KCB101/Frankenbook/Pictures/Battery/IMG_3732.jpg

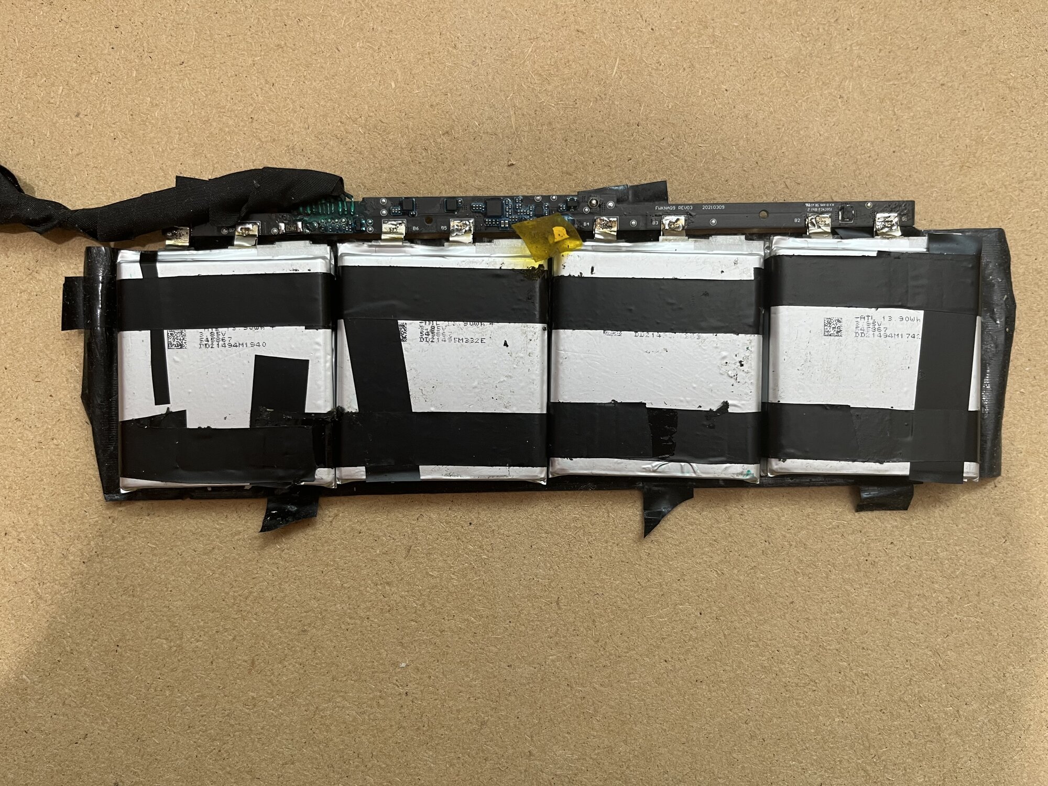
Pictures/Battery/IMG_3732.jpg
