KCB101/Frankenbook/Pictures/Various/IMG_3710.jpg

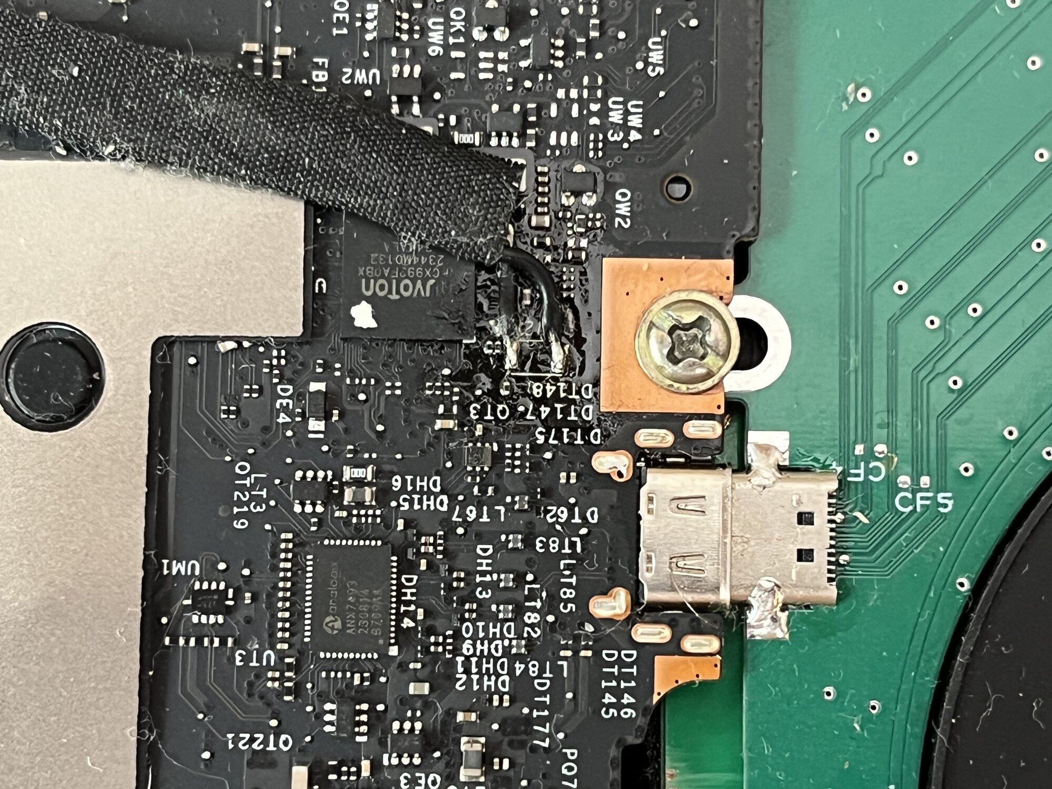
Pictures/Various/IMG_3710.jpg
