KCB101/Frankenbook/ReadMe

This Repo contains the files I used to build my laptop. Also contains some pictures of the parts I build (and modified).
