KCB101/Frankenbook/PCB Design/ReadMe

All PCB Designs were created using Designspark PCB 11.
Some PCB designs had to be modified to work. There is no guarantee that they will work if build exacltly as given. 
The holders and the chargestate PCB is known to need modification as can be seen in the pictures.
