KCB101/Frankenbook/CAD/ReadMe

In this directory all CAD files used for the design are stored. They are all created using Autodesk Inventor 2024.
