KCB101/Frankenbook/Pictures/Full/ReadMe

The green PCBs are the components I build my self. They are build around a framework 13 mainboard.
