KCB101/Frankenbook/Pictures/Speakers/ReadMe

The speakers are force canceling speakers. I first used Frameworks speakers but they rattled
the keyboard and sounded bad. Without EasyEffects they still sound very bad, a dedicated 
DSP would be good but too much work for me.
