KCB101/Frankenbook/CAD/Speaker/ReadMe

The speakers are force canceling speakers using the PUI Audio AS03404MO-SP34 drivers. 
The drivers are two in parallel of two drivers in series for four drivers for each speaker.
The housing for the second side is just mirrored. It is printed using a resin 3d printer.
