KCB101/Frankenbook/Pictures/Battery/IMG_3729.jpg

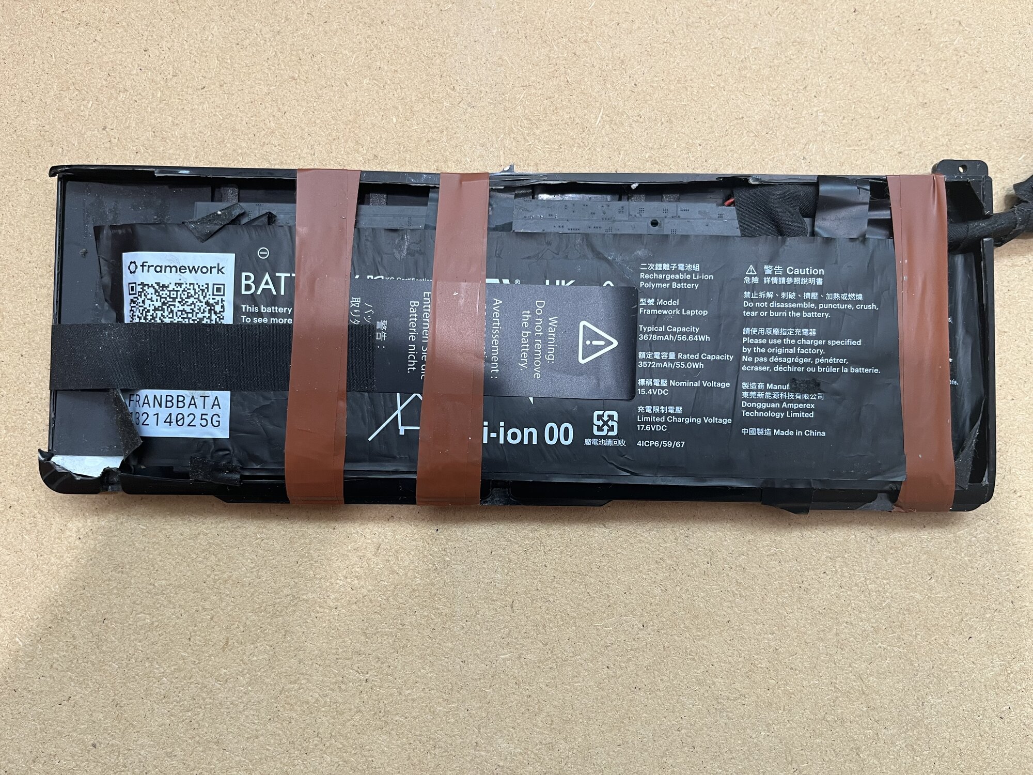
Pictures/Battery/IMG_3729.jpg
