KCB101/Frankenbook/Pictures/Battery/IMG_3730.jpg

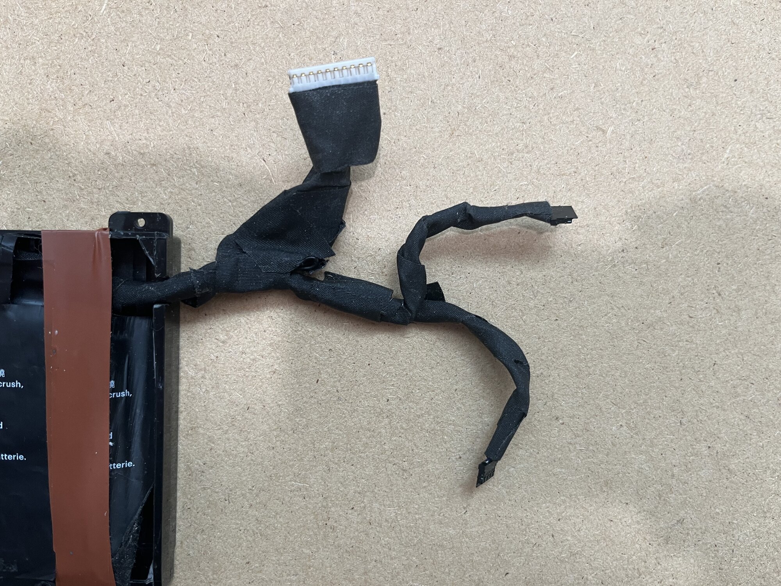
Pictures/Battery/IMG_3730.jpg
