KCB101/Frankenbook/Pictures/Battery/IMG_3733.jpg

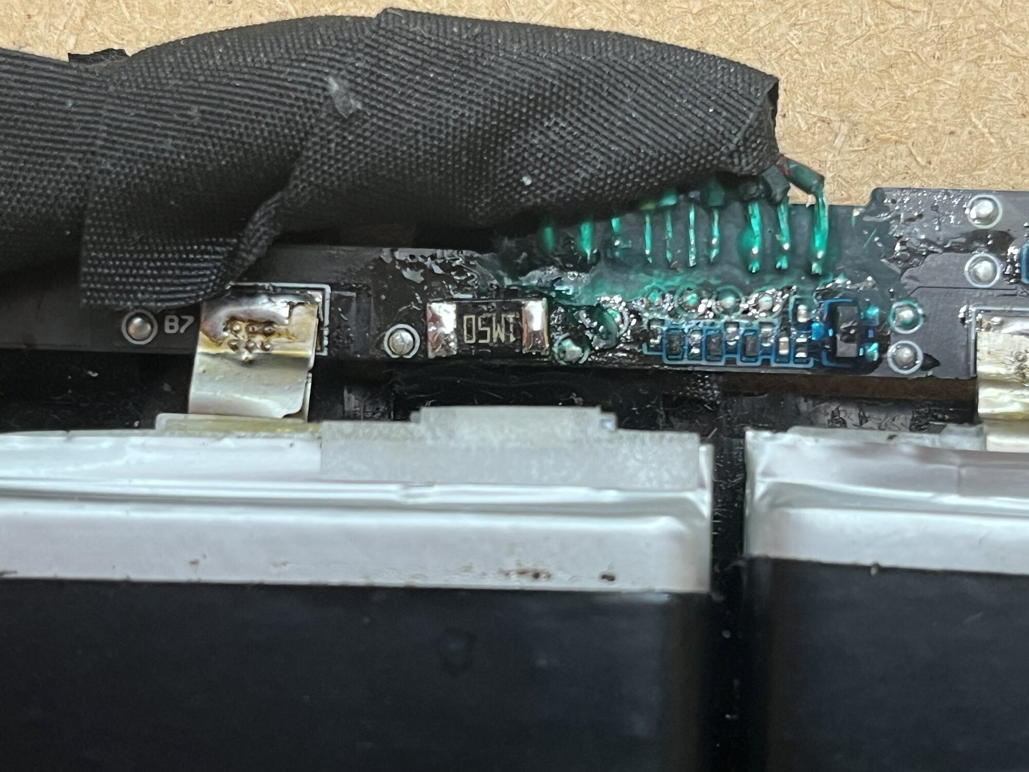
Pictures/Battery/IMG_3733.jpg
