KCB101/Frankenbook/Pictures/Battery/IMG_3735.jpg

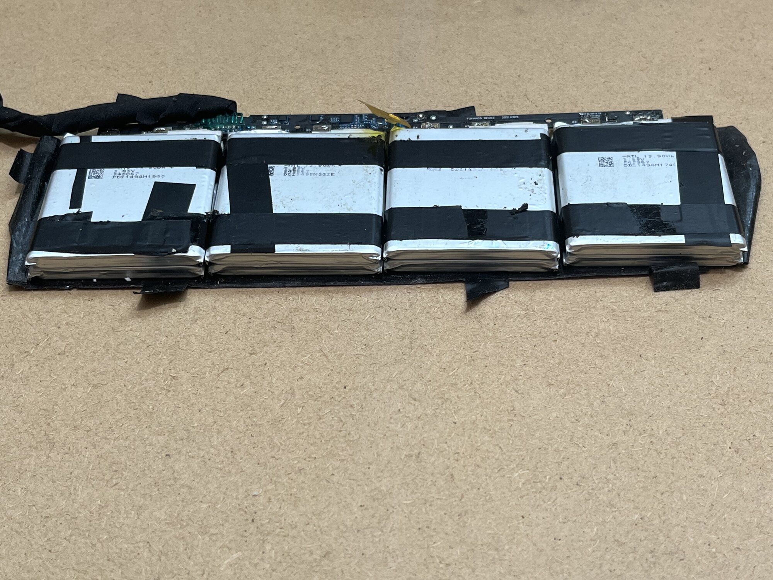
Pictures/Battery/IMG_3735.jpg
