KCB101/Frankenbook/Pictures/Charge State Indicator/IMG_3707.jpg

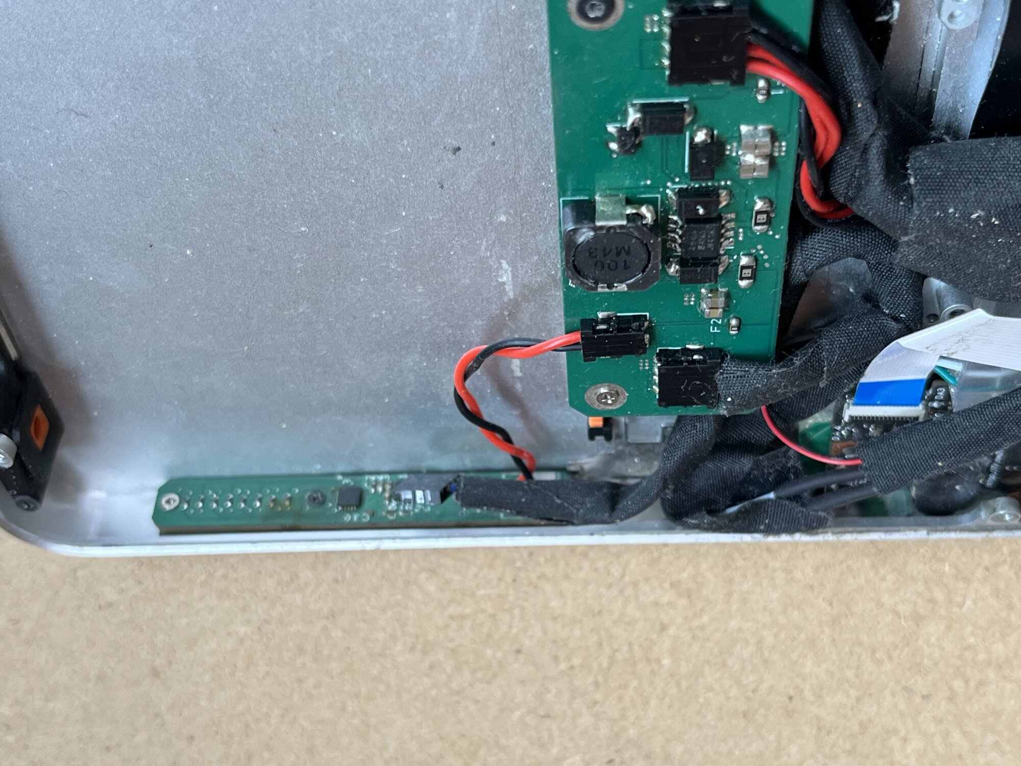
Pictures/Charge State Indicator/IMG_3707.jpg
