KCB101/Frankenbook/Pictures/Charge State Indicator/IMG_3736.jpg

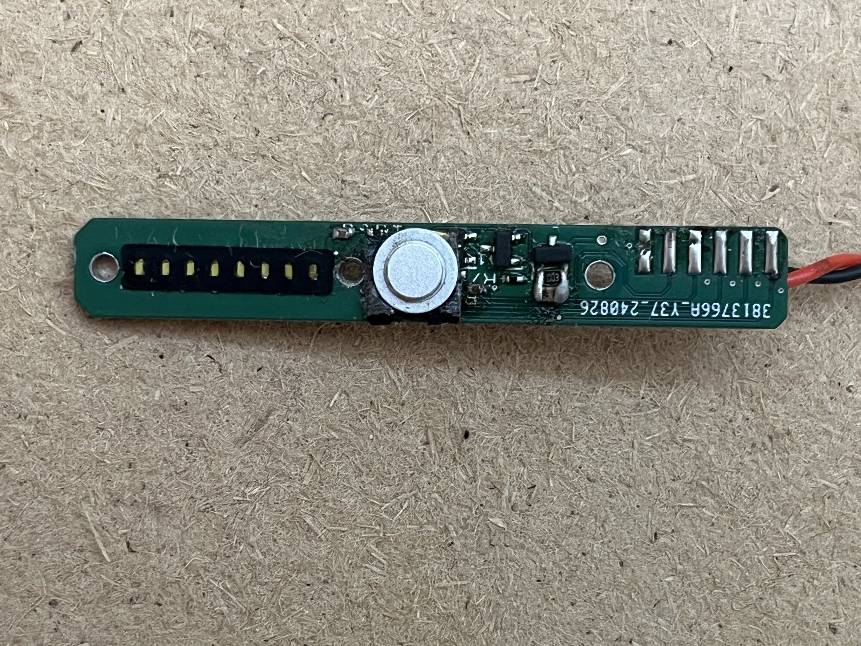
Pictures/Charge State Indicator/IMG_3736.jpg
