KCB101/Frankenbook/Pictures/Charge State Indicator/IMG_3737.jpg

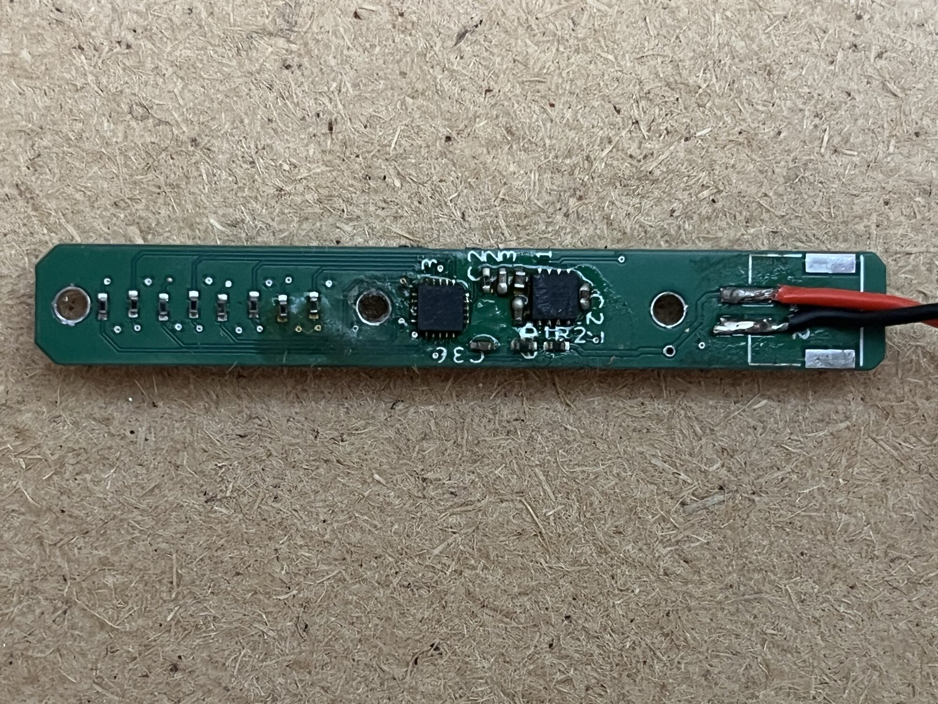
Pictures/Charge State Indicator/IMG_3737.jpg
