KCB101/Frankenbook/Pictures/Charger/IMG_3709.jpg

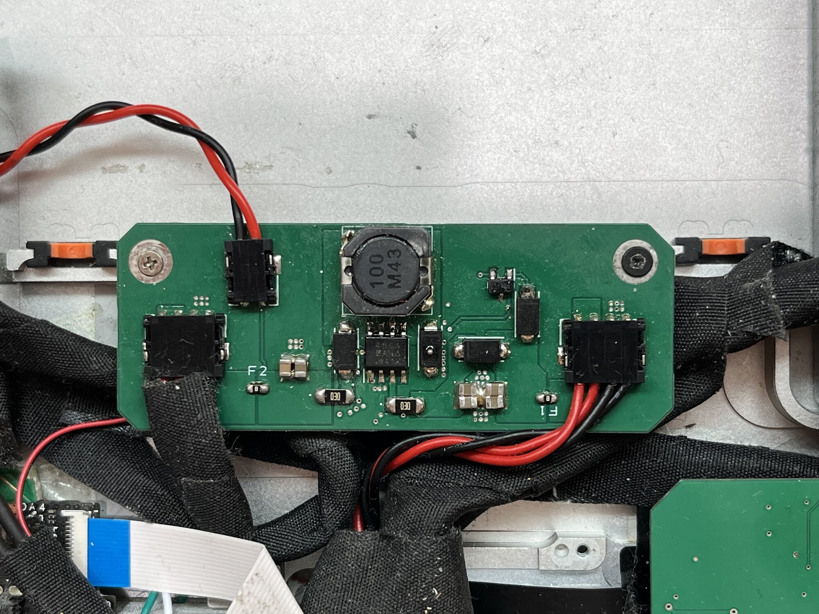
Pictures/Charger/IMG_3709.jpg
