KCB101/Frankenbook/Pictures/Charger/IMG_3727.jpg

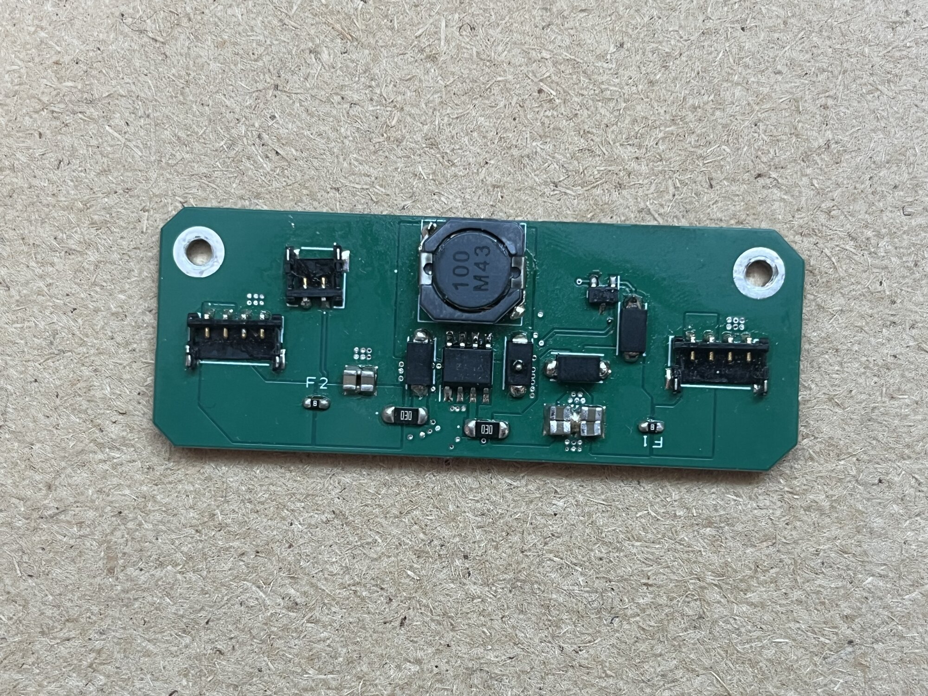
Pictures/Charger/IMG_3727.jpg
