KCB101/Frankenbook/Pictures/Charger/IMG_3728.jpg

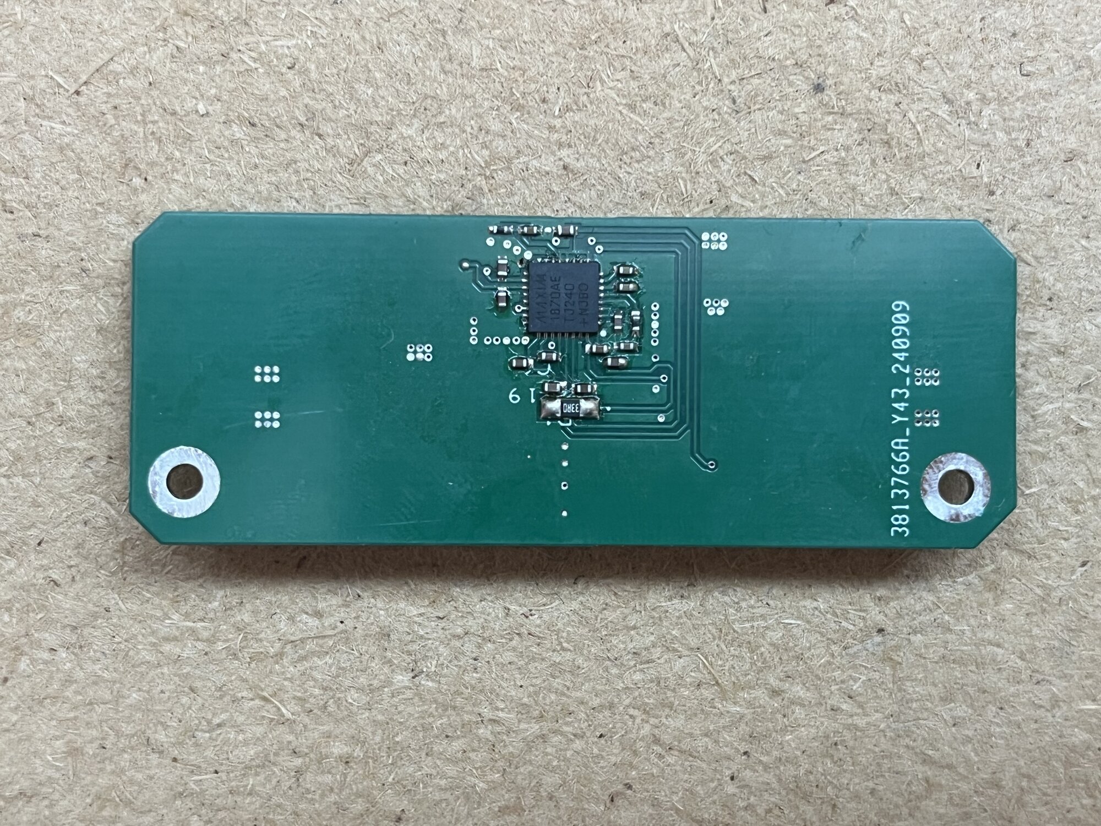
Pictures/Charger/IMG_3728.jpg
