KCB101/Frankenbook/Pictures/External Ports/IMG_3720.jpg

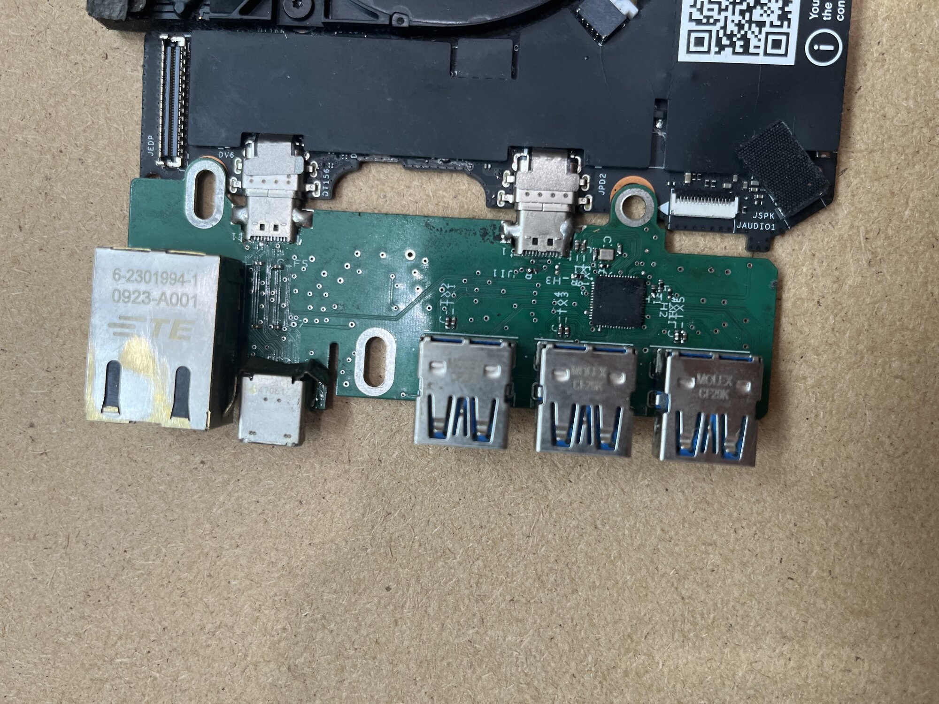
Pictures/External Ports/IMG_3720.jpg
