KCB101/Frankenbook/Pictures/External Ports/IMG_3721.jpg

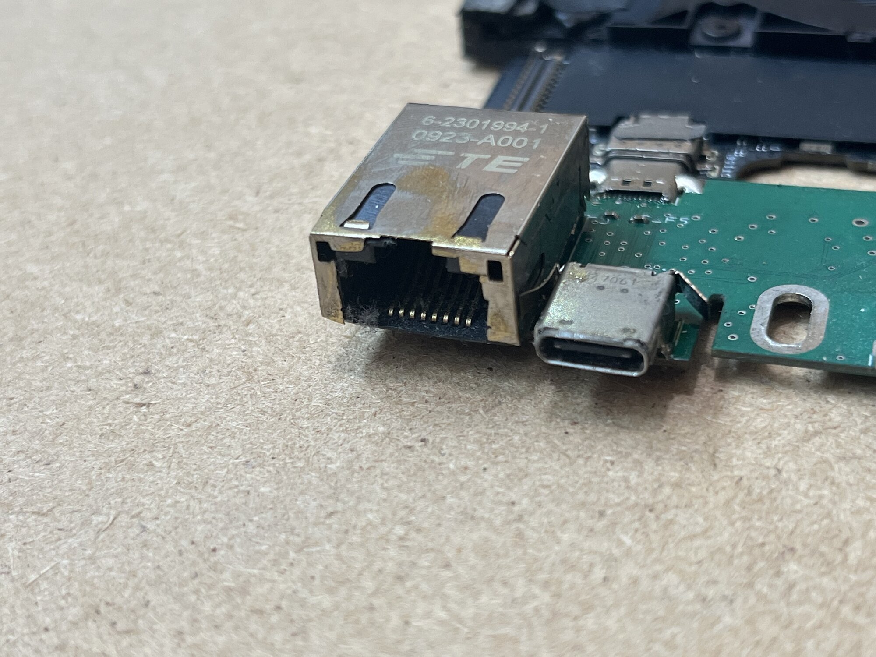
Pictures/External Ports/IMG_3721.jpg
