KCB101/Frankenbook/Pictures/External Ports/IMG_3722.jpg

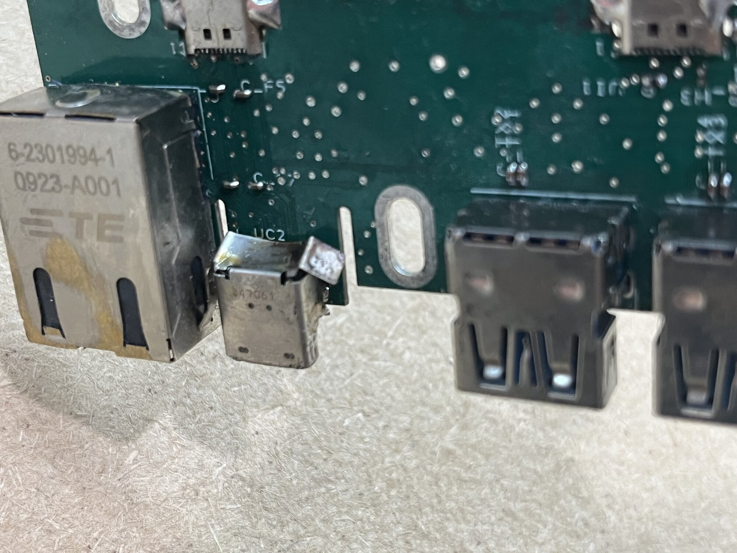
Pictures/External Ports/IMG_3722.jpg
