KCB101/Frankenbook/Pictures/Fans/IMG_3711.jpg

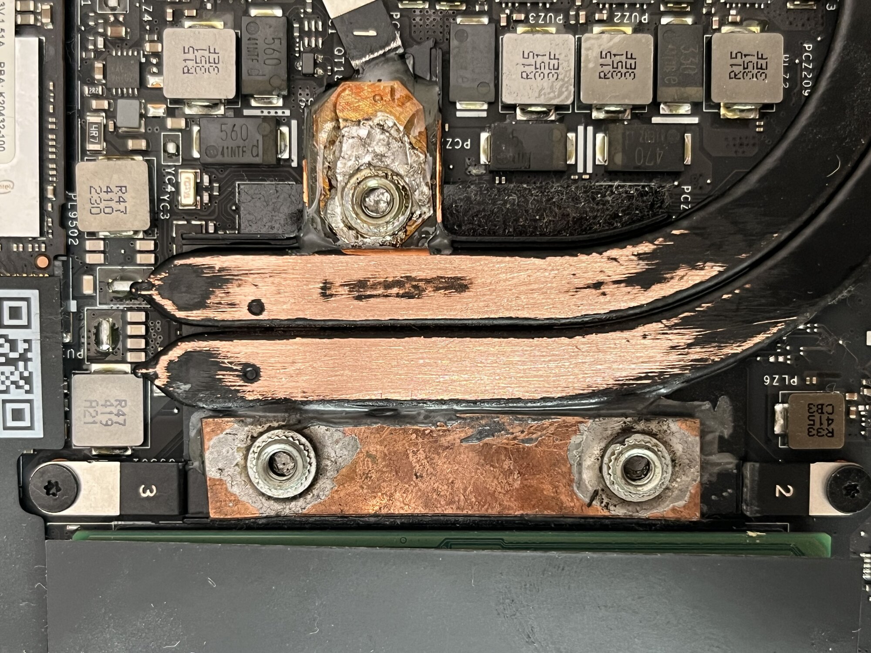
Pictures/Fans/IMG_3711.jpg
