KCB101/Frankenbook/Pictures/Fans/IMG_3714.jpg

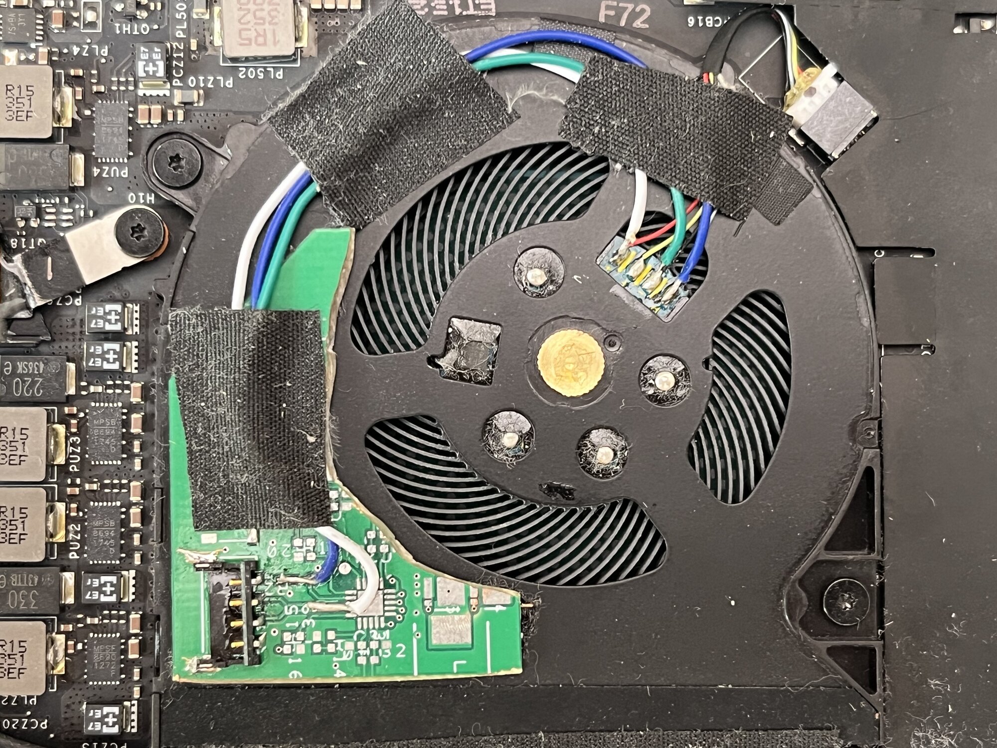
Pictures/Fans/IMG_3714.jpg
