KCB101/Frankenbook/Pictures/Fans/IMG_3715.jpg

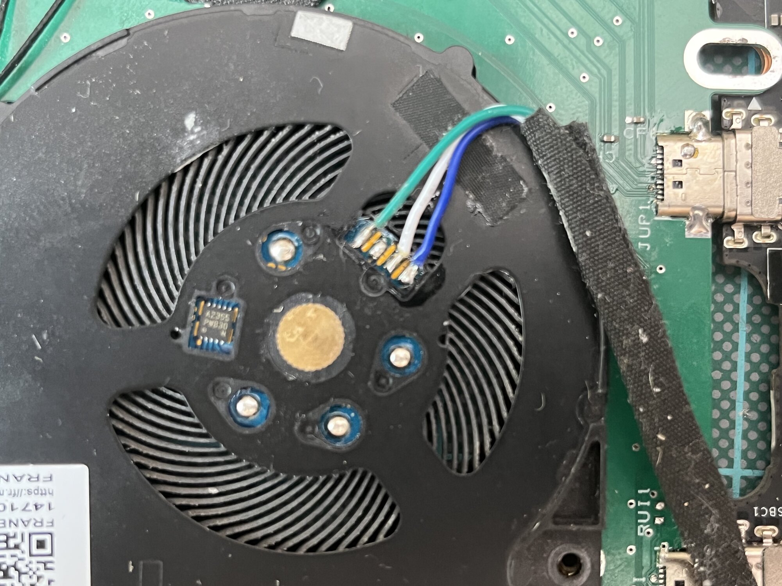
Pictures/Fans/IMG_3715.jpg
