KCB101/Frankenbook/Pictures/Fans/IMG_3719.jpg

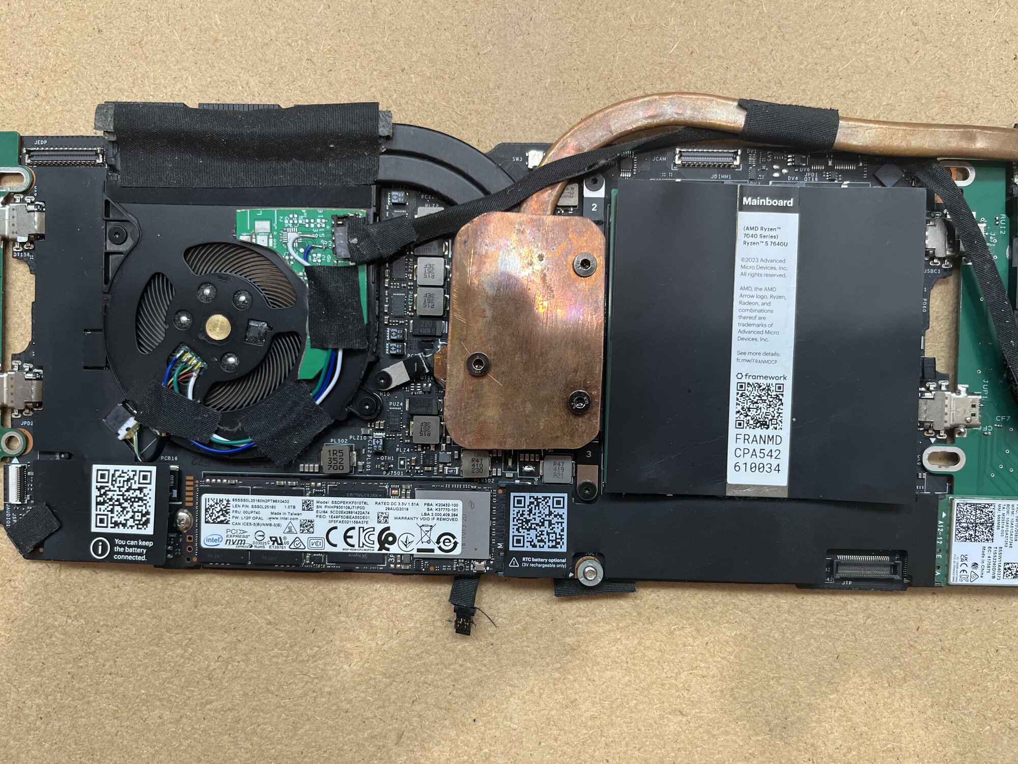
Pictures/Fans/IMG_3719.jpg
