KCB101/Frankenbook/Pictures/Full/IMG_3703.jpg

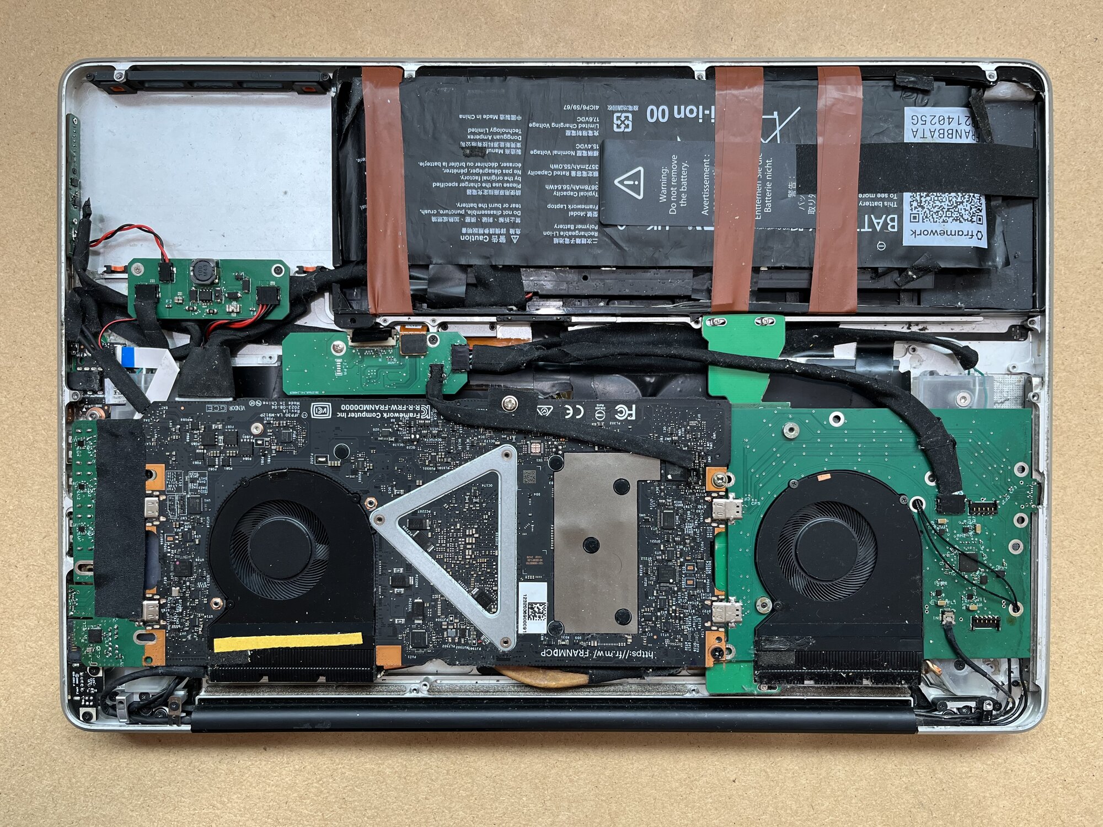
Pictures/Full/IMG_3703.jpg
