KCB101/Frankenbook/Pictures/Full/IMG_3706.jpg

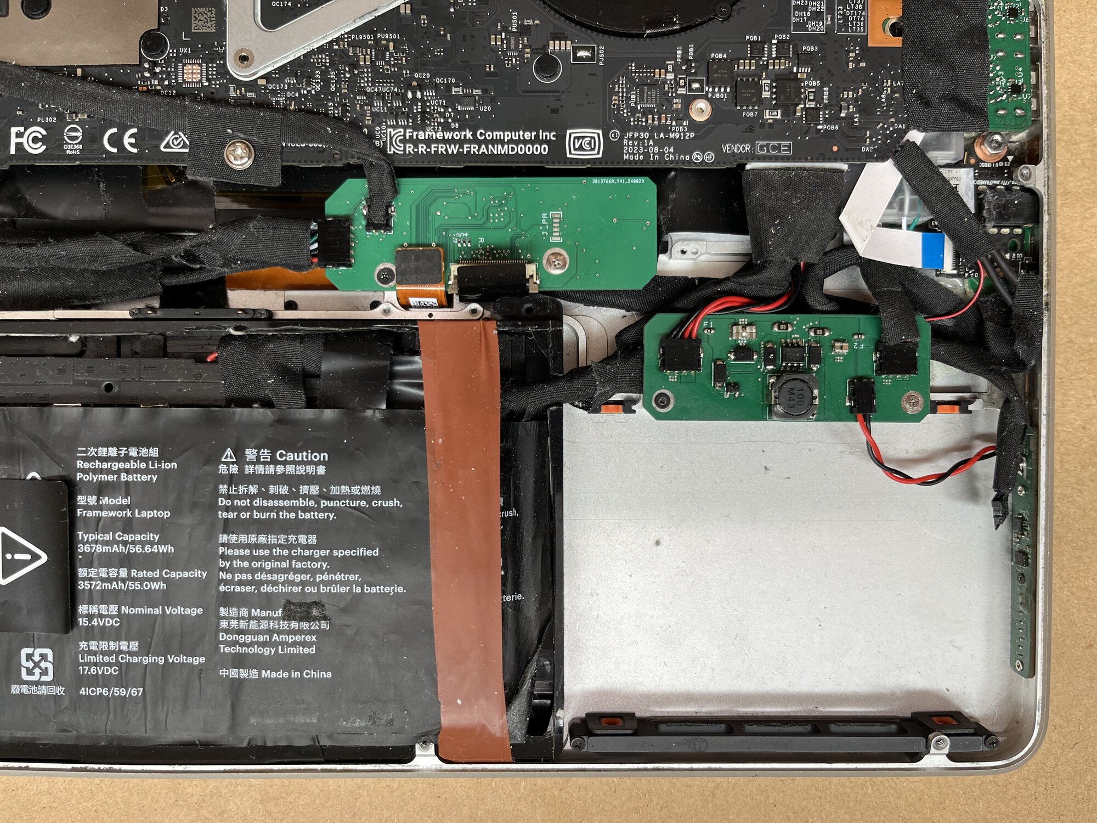
Pictures/Full/IMG_3706.jpg
