KCB101/Frankenbook/Pictures/Full/IMG_3716.jpg

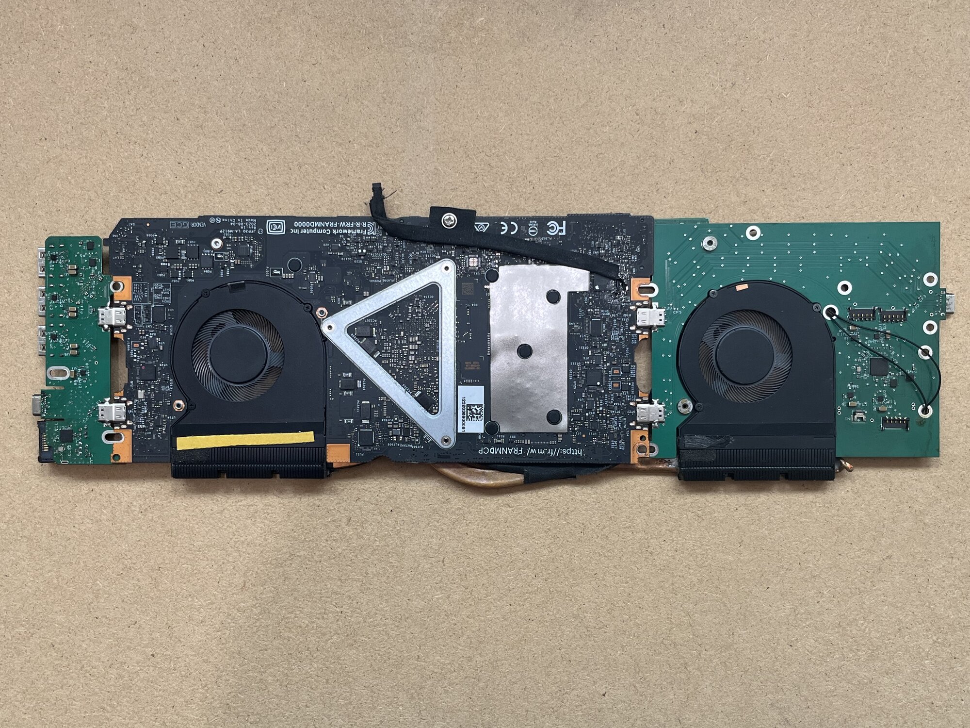
Pictures/Full/IMG_3716.jpg
