KCB101/Frankenbook/Pictures/Full/IMG_3717.jpg

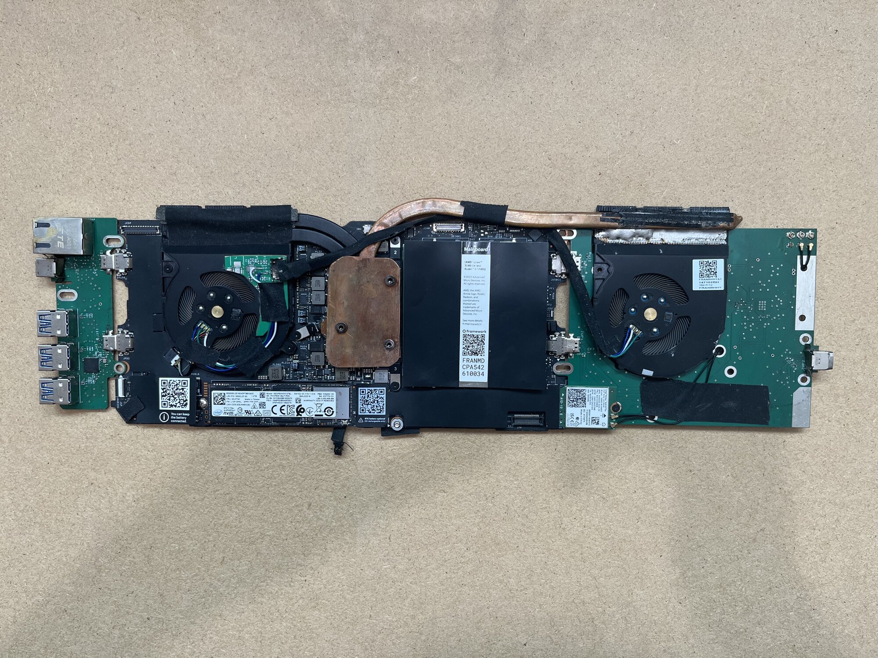
Pictures/Full/IMG_3717.jpg
