KCB101/Frankenbook/Pictures/Full/IMG_3724.jpg

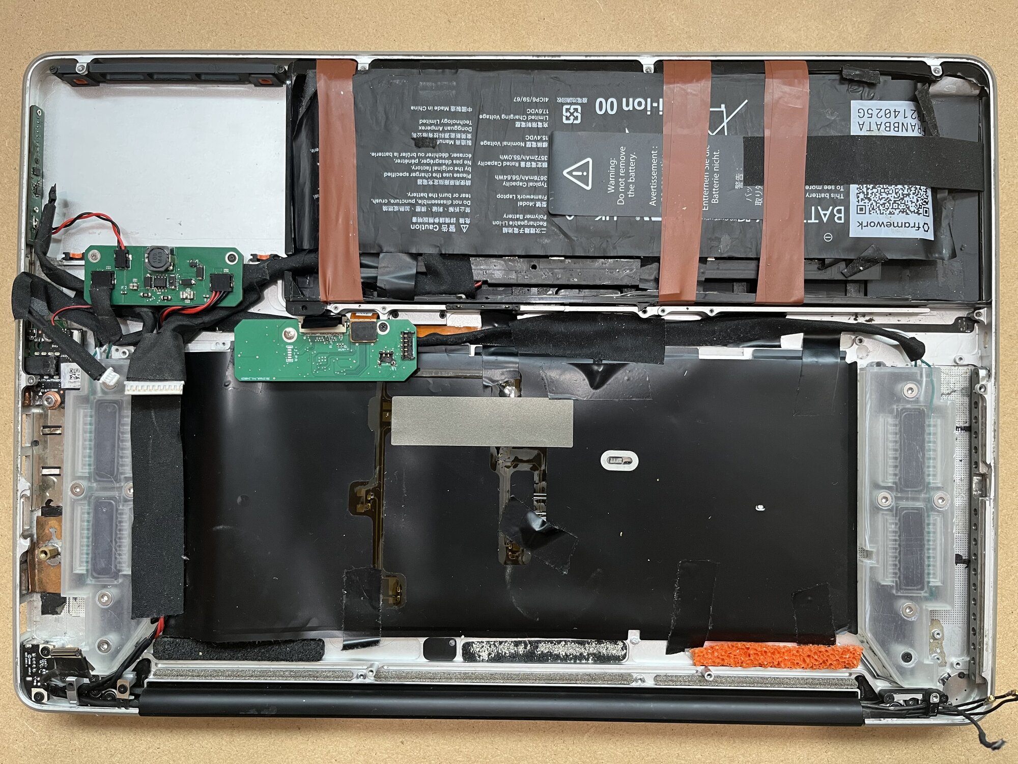
Pictures/Full/IMG_3724.jpg
