KCB101/Frankenbook/Pictures/Keyboard Handler/IMG_3708.jpg

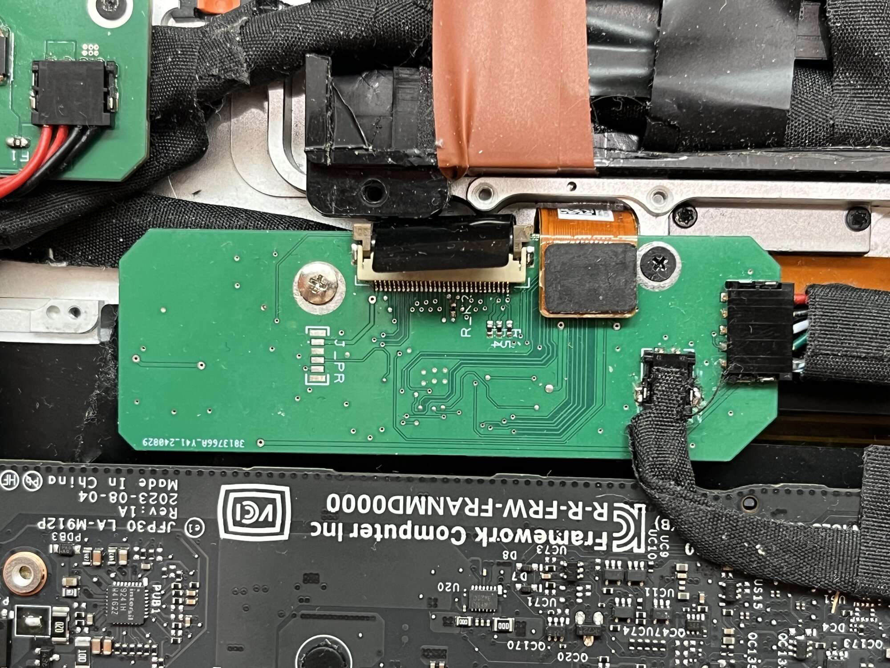
Pictures/Keyboard Handler/IMG_3708.jpg
