KCB101/Frankenbook/Pictures/Keyboard Handler/IMG_3738.jpg

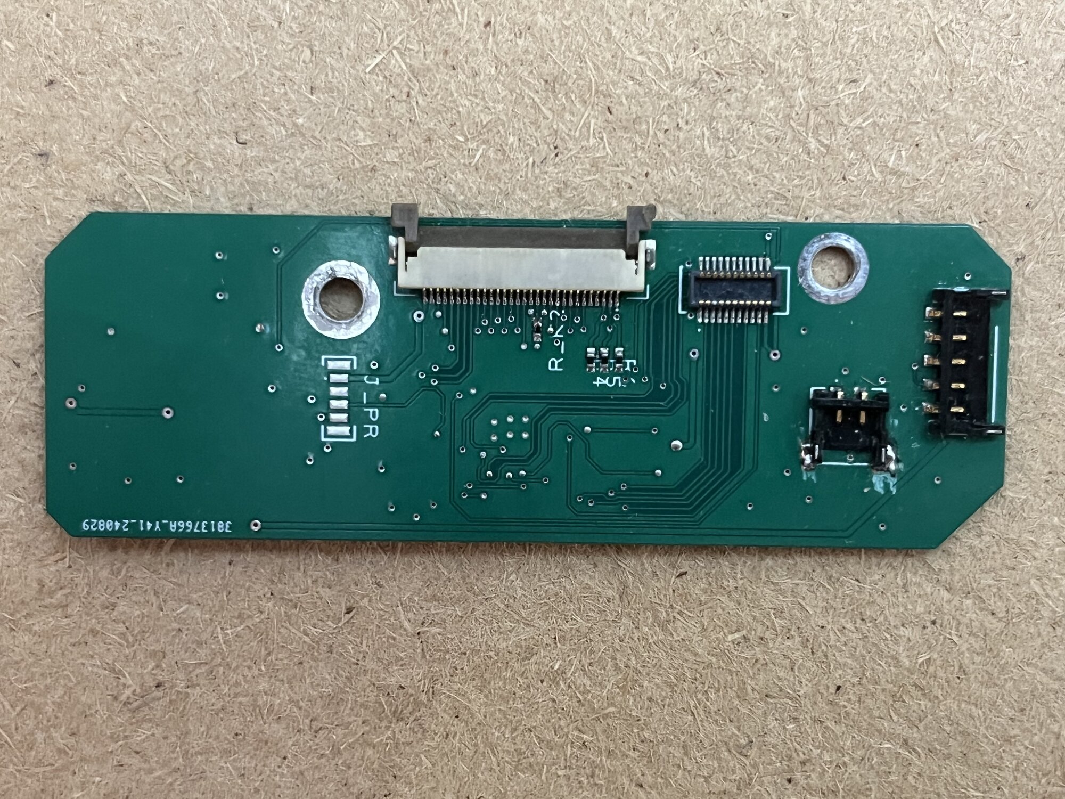
Pictures/Keyboard Handler/IMG_3738.jpg
