KCB101/Frankenbook/Pictures/Keyboard Handler/IMG_3739.jpg

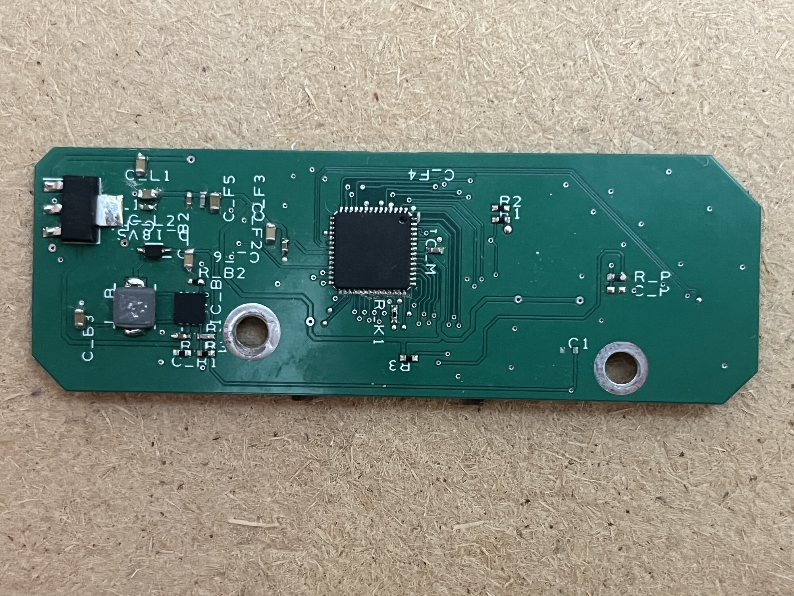
Pictures/Keyboard Handler/IMG_3739.jpg
