KCB101/Frankenbook/Pictures/PCB Internal Ports/IMG_3704.jpg

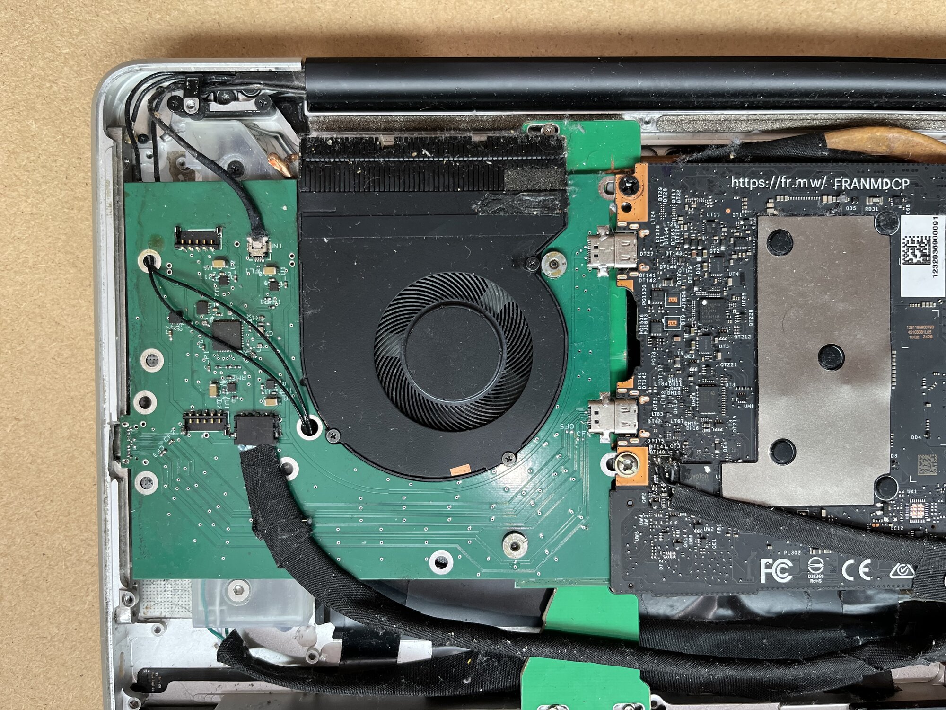
Pictures/PCB Internal Ports/IMG_3704.jpg
