KCB101/Frankenbook/Pictures/PCB Internal Ports/IMG_3712.jpg

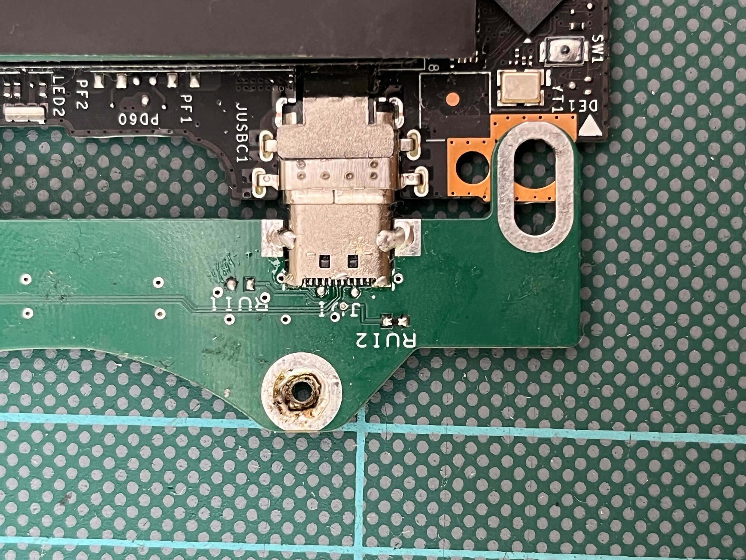
Pictures/PCB Internal Ports/IMG_3712.jpg
