KCB101/Frankenbook/Pictures/PCB Internal Ports/IMG_3718.jpg

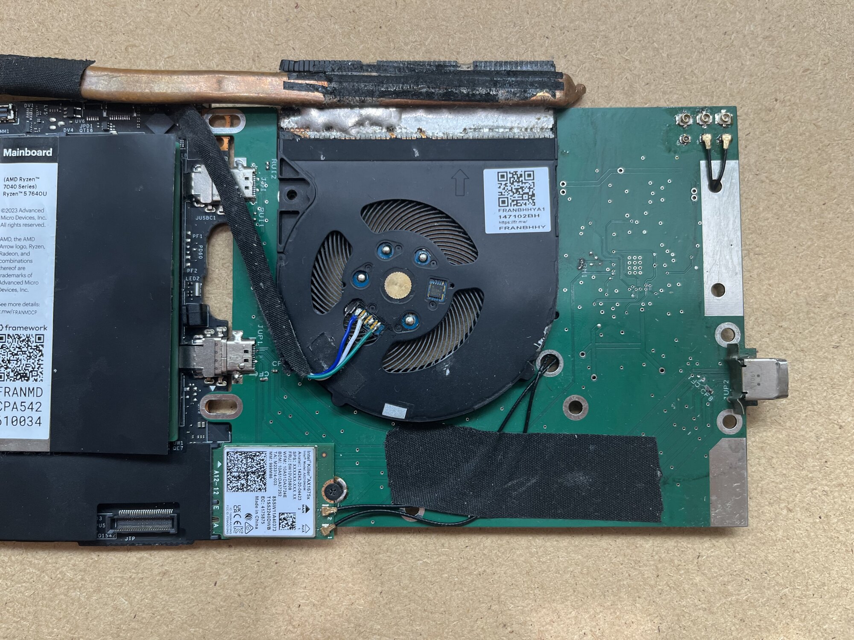
Pictures/PCB Internal Ports/IMG_3718.jpg
