KCB101/Frankenbook/Pictures/PCB Internal Ports/IMG_3723.jpg

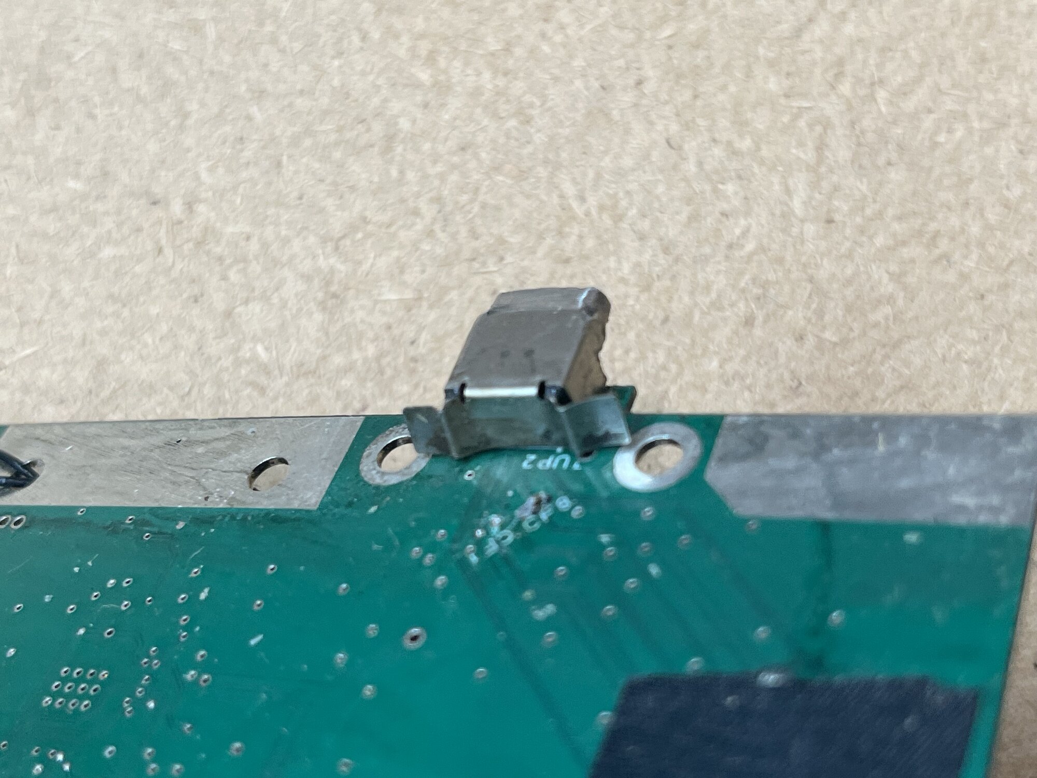
Pictures/PCB Internal Ports/IMG_3723.jpg
