KCB101/Frankenbook/Pictures/Screen/IMG_3741.jpg

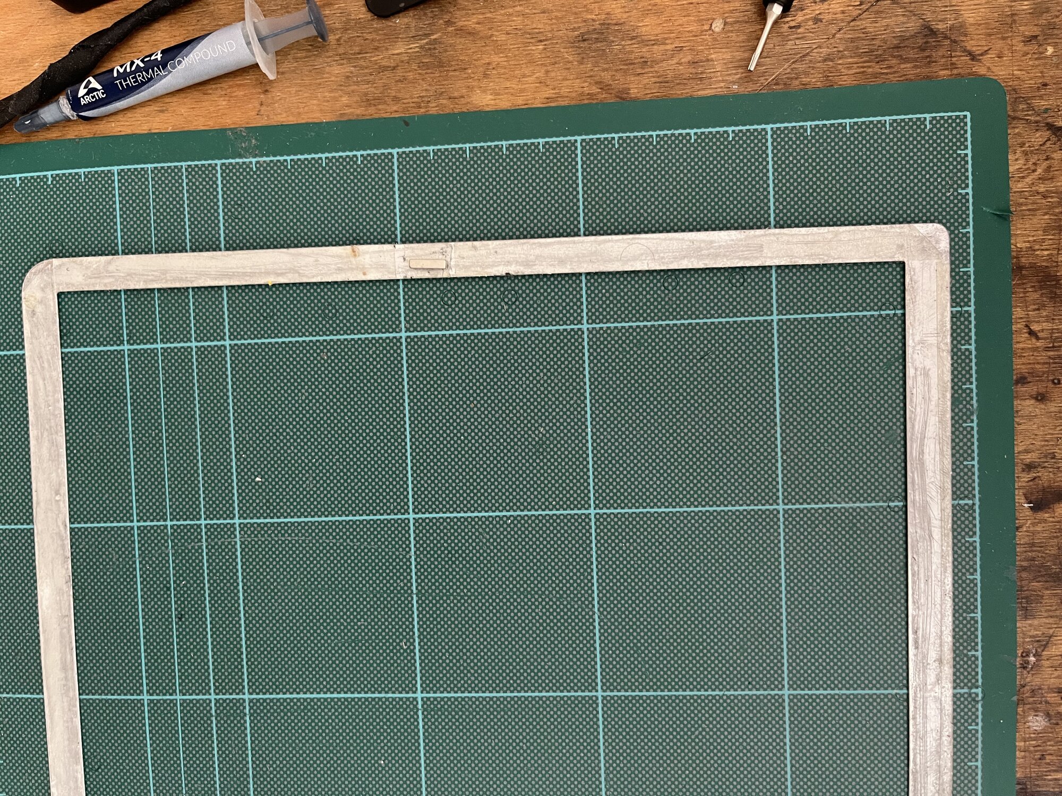
Pictures/Screen/IMG_3741.jpg
