KCB101/Frankenbook/Pictures/Screen/IMG_3742.jpg

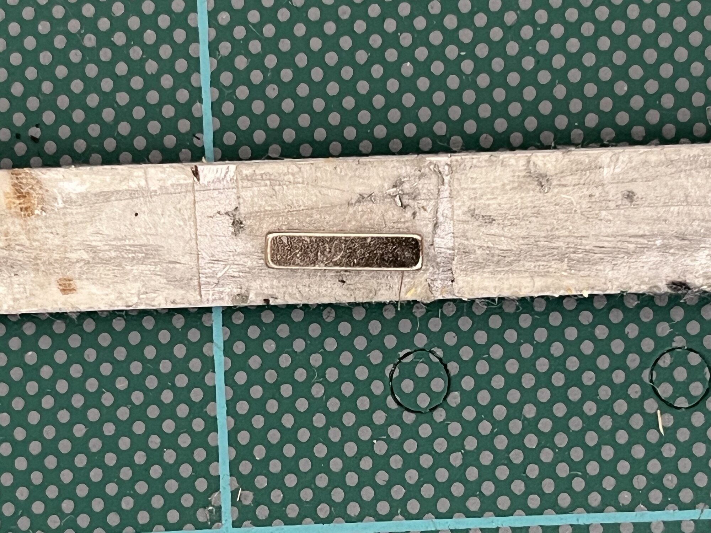
Pictures/Screen/IMG_3742.jpg
