KCB101/Frankenbook/Pictures/Screen/IMG_3745.jpg

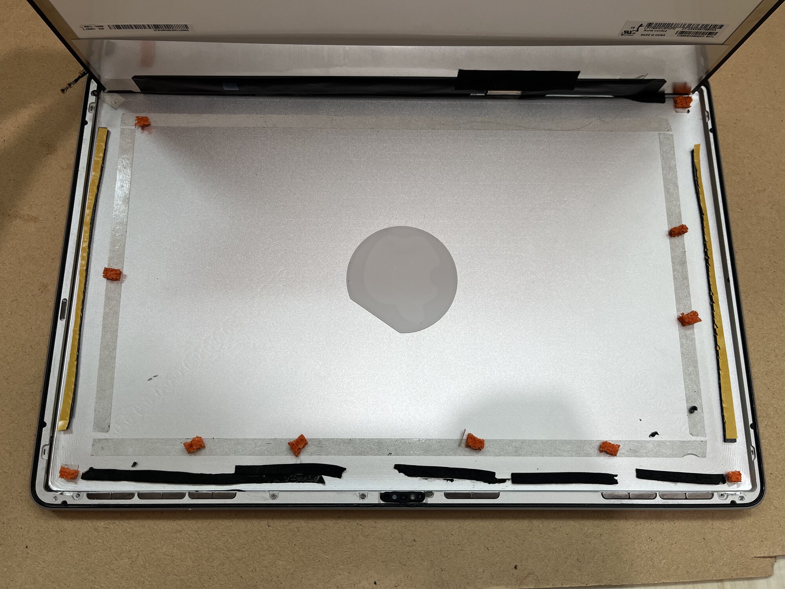
Pictures/Screen/IMG_3745.jpg
