KCB101/Frankenbook/Pictures/Screen/IMG_3746.jpg

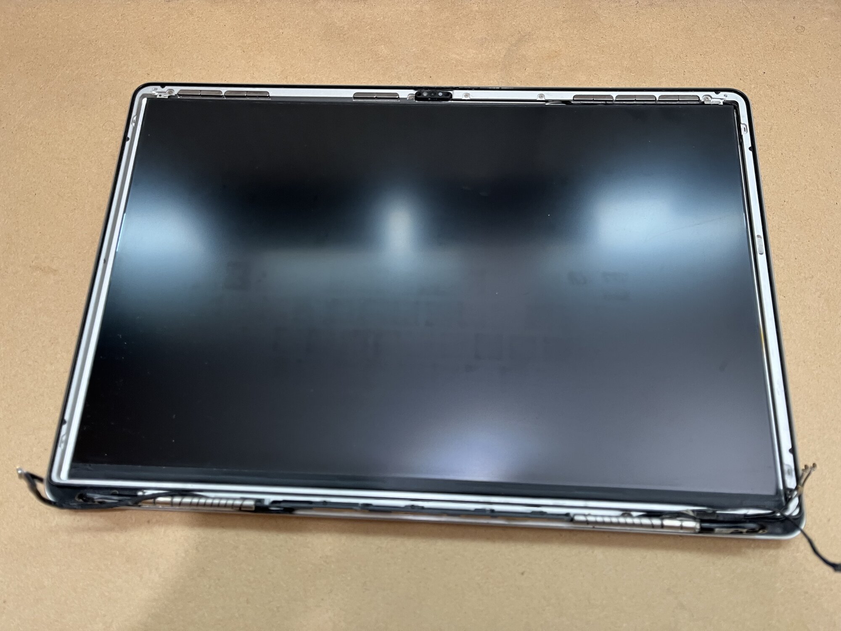
Pictures/Screen/IMG_3746.jpg
