KCB101/Frankenbook/Pictures/Screen/IMG_3747.jpg

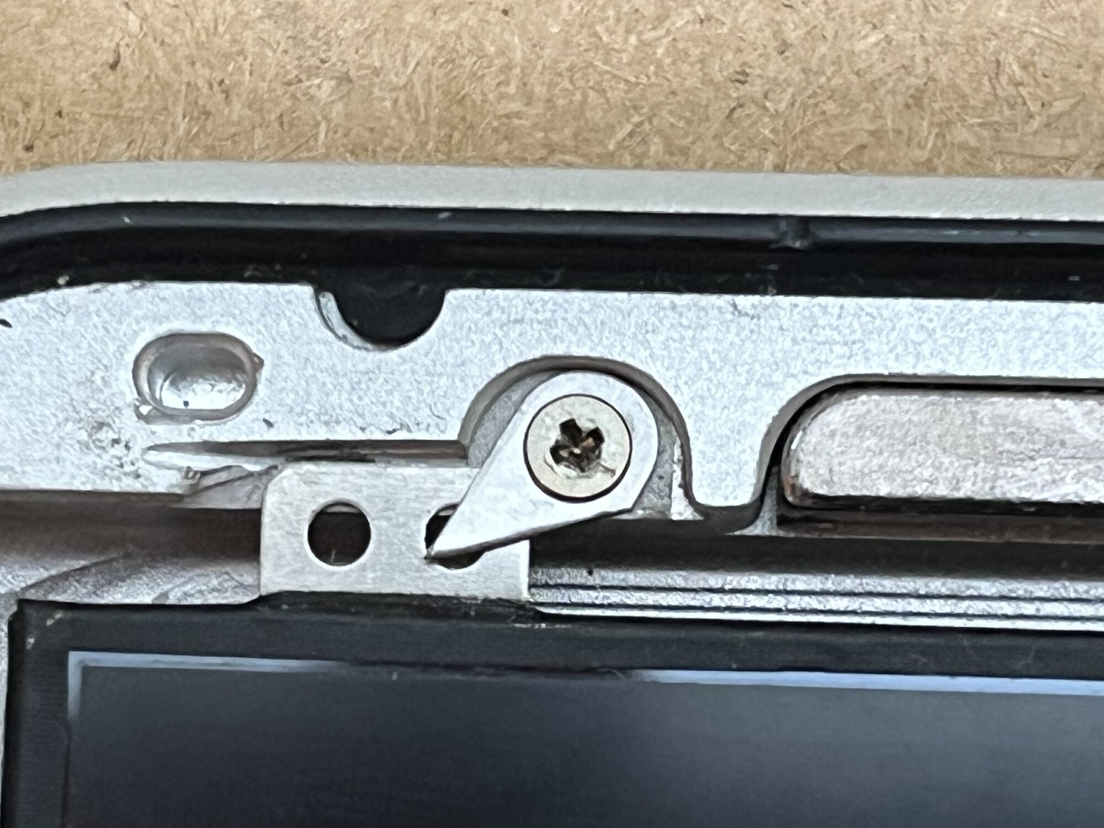
Pictures/Screen/IMG_3747.jpg
