KCB101/Frankenbook/Pictures/Screen/IMG_3748.jpg

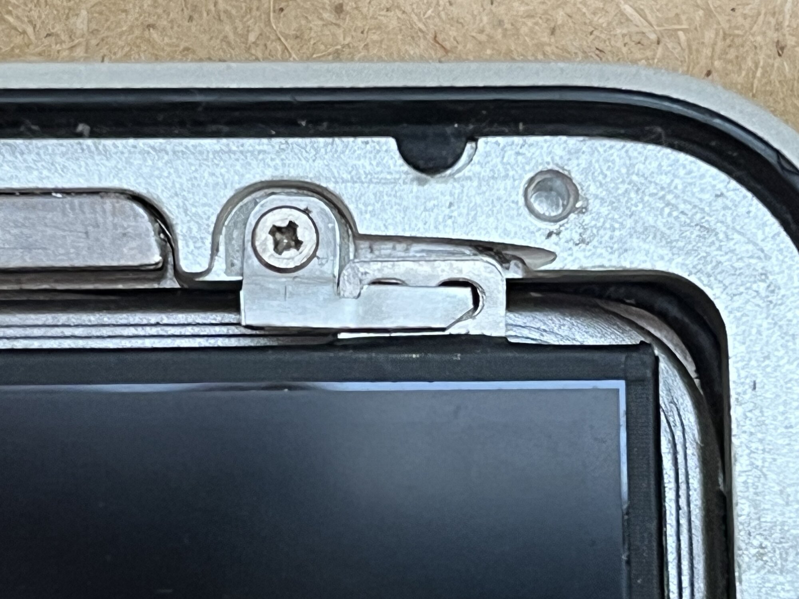
Pictures/Screen/IMG_3748.jpg
