KCB101/Frankenbook/Pictures/Speakers/IMG_3725.jpg

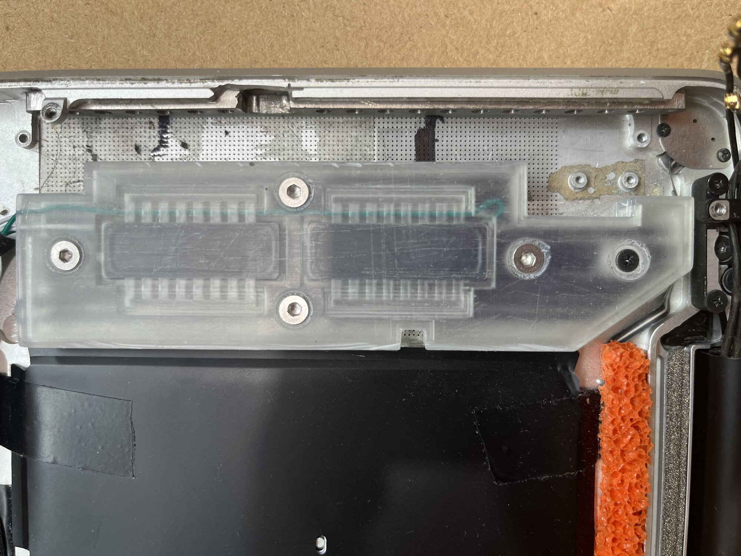
Pictures/Speakers/IMG_3725.jpg
