KCB101/Frankenbook/Pictures/Speakers/IMG_3726.jpg

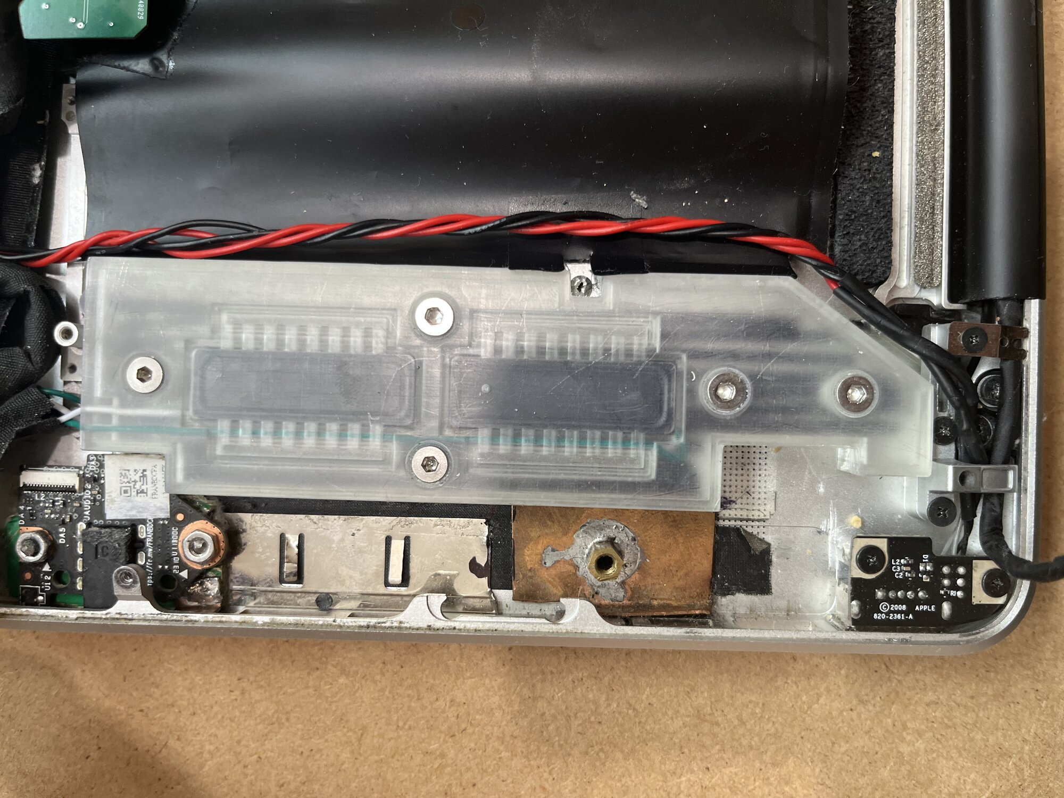
Pictures/Speakers/IMG_3726.jpg
