KCB101/Frankenbook/Pictures/Various/IMG_3740.jpg

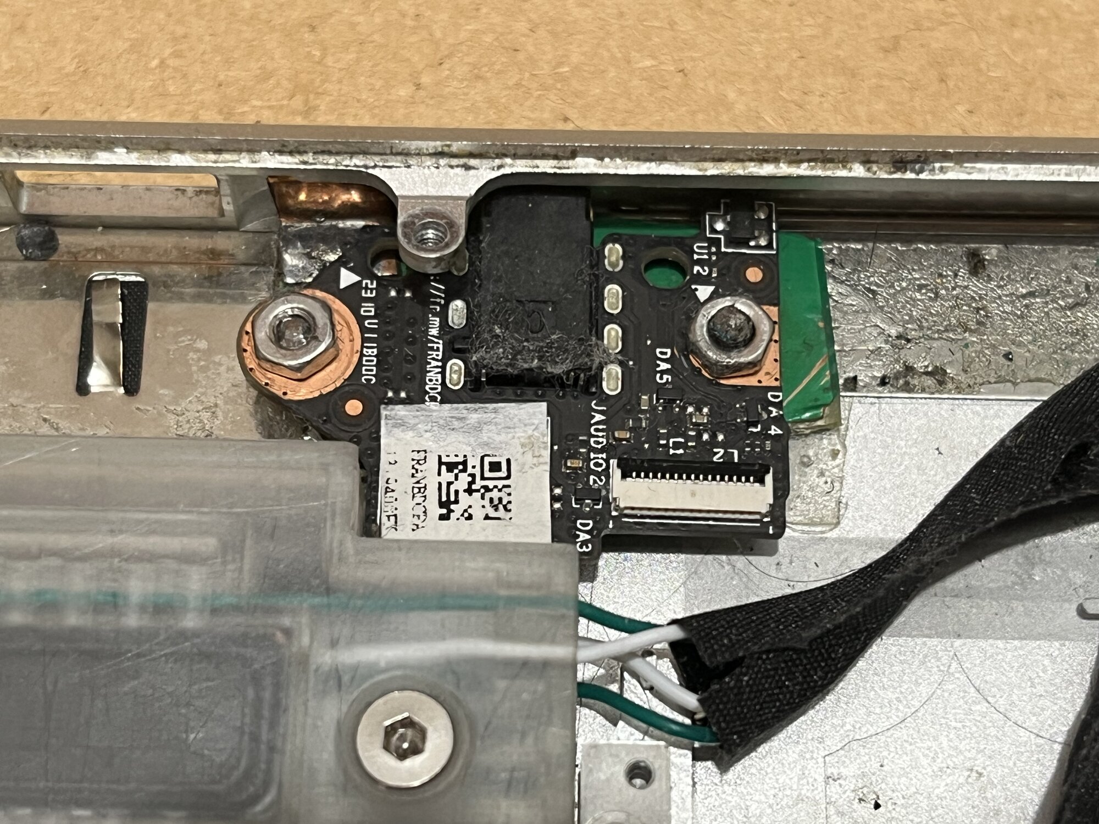
Pictures/Various/IMG_3740.jpg
