KCB101/Frankenbook/Pictures/Various/IMG_3749.jpg

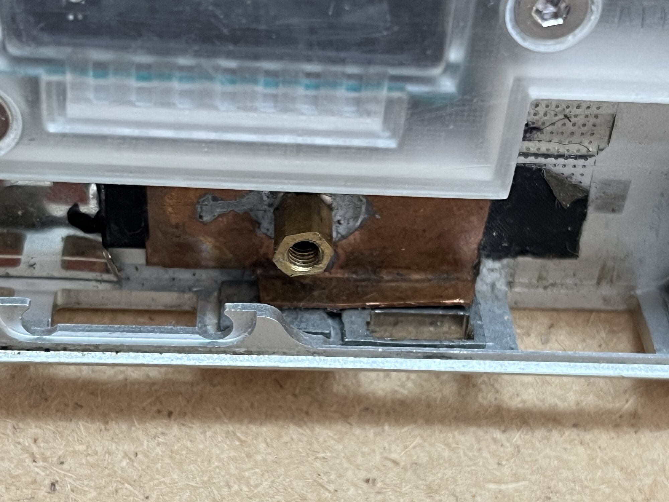
Pictures/Various/IMG_3749.jpg
