KCB101/Frankenbook/Pictures/Various/IMG_3750.jpg

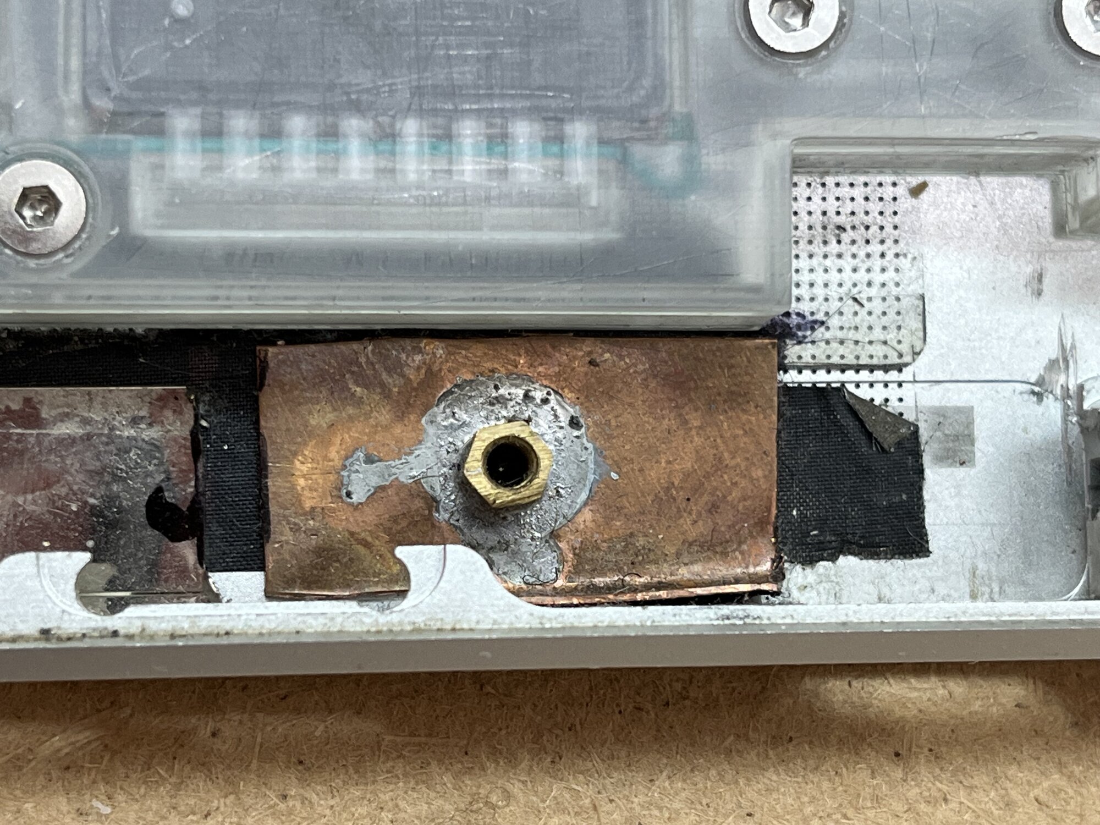
Pictures/Various/IMG_3750.jpg
