KCB101/Frankenbook/Pictures/Various/IMG_3751.jpg

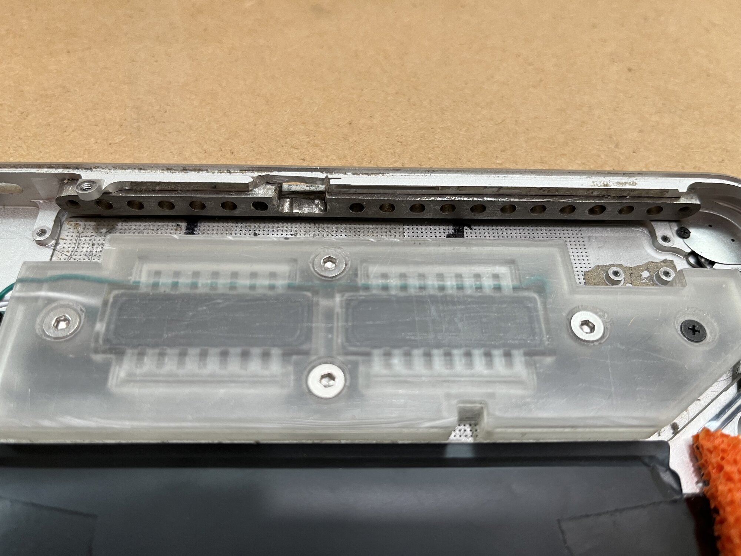
Pictures/Various/IMG_3751.jpg
