KCB101/Frankenbook/Pictures/Various/IMG_3752.jpg

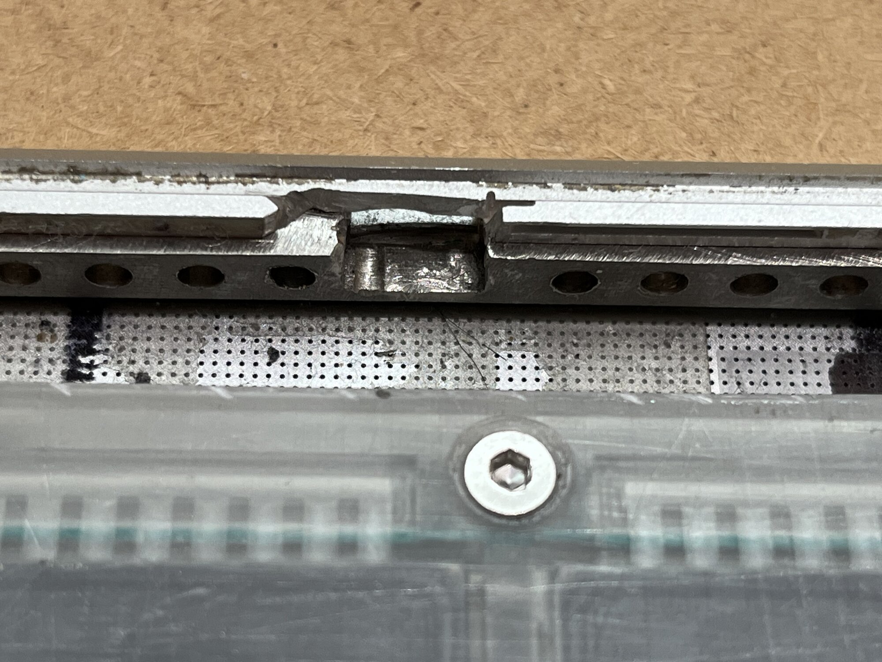
Pictures/Various/IMG_3752.jpg
