KCB101/Frankenbook/Pictures/Various/IMG_3753.jpg

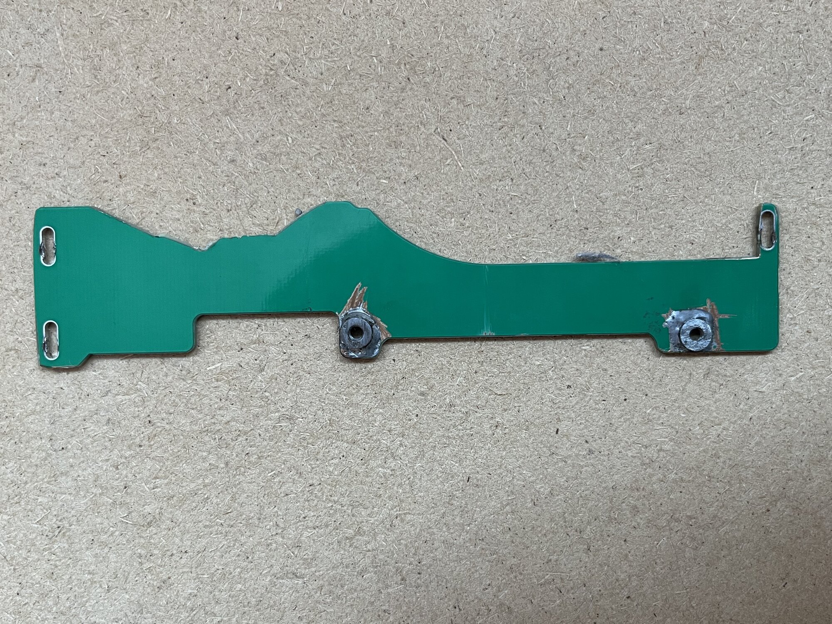
Pictures/Various/IMG_3753.jpg
