KCB101/Frankenbook/Pictures/Webcam/2025-04-19-170600.jpg

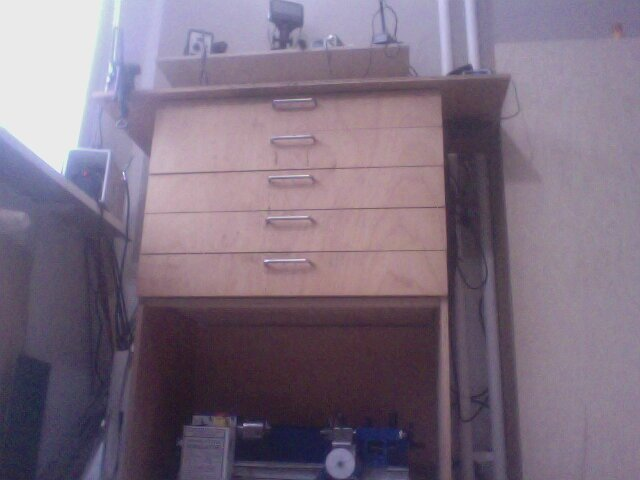
Pictures/Webcam/2025-04-19-170600.jpg
