KCB101/Frankenbook/CAD/Speaker/Speaker Assembly.igs

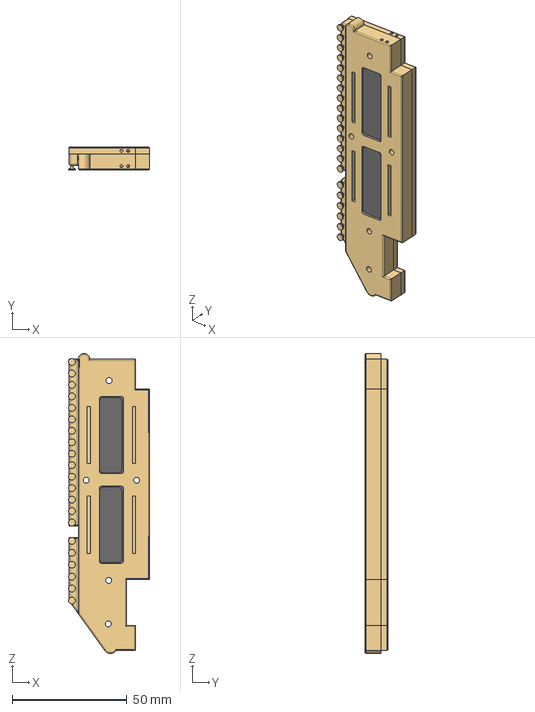
[picture p47: CAD file, 2025-08-28]
CAD/Speaker/Speaker Assembly.igs
35.3 x 10.0 x 130.8 mm
