KCB101/Frankenbook/CAD/Housing Parts/firewire.igs

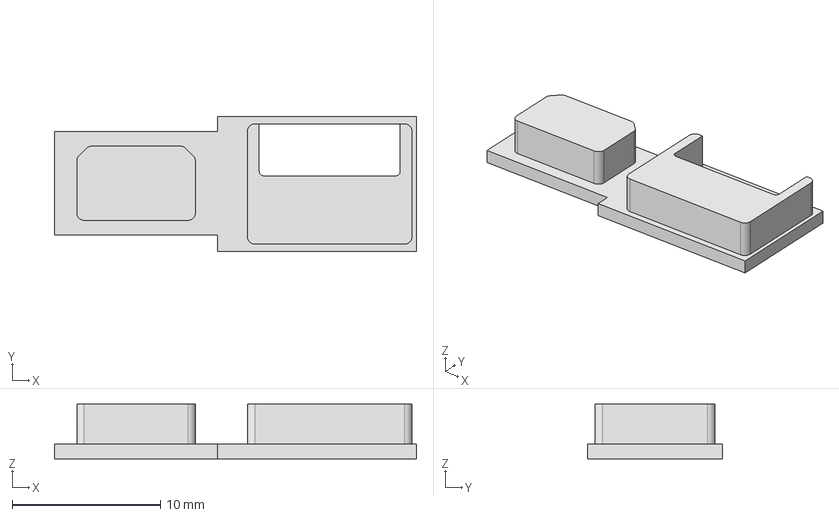
[picture p48: CAD file, 2025-04-19]
CAD/Housing Parts/firewire.igs
24.4 x 9.10 x 3.70 mm
