KCB101/Frankenbook/CAD/Speaker/Speaker Housing Bottom.igs

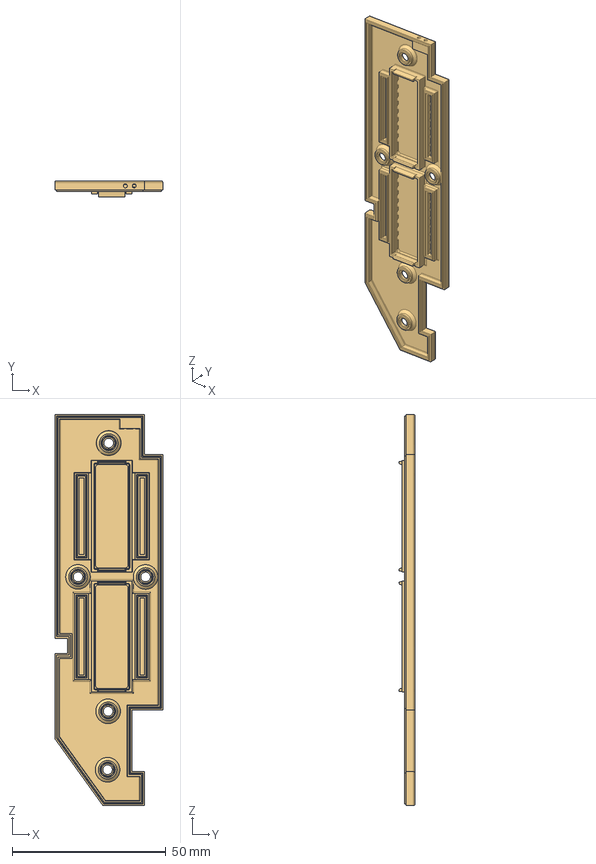
[picture p49: CAD file, 2025-08-28]
CAD/Speaker/Speaker Housing Bottom.igs
35.0 x 5.30 x 127.0 mm
