KCB101/Frankenbook/CAD/Housing Parts/dvddrive.igs

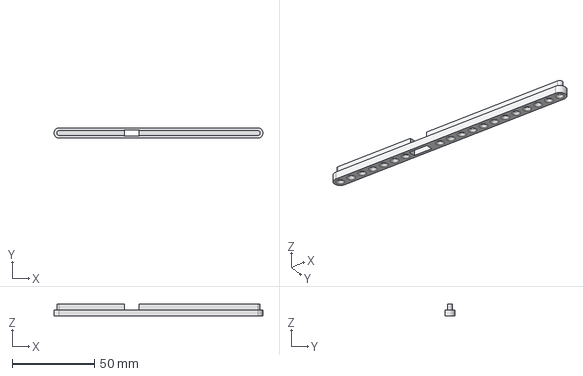
[picture p50: CAD file, 2025-04-19]
CAD/Housing Parts/dvddrive.igs
127.2 x 6.30 x 7.00 mm
