KCB101/Frankenbook/CAD/Speaker/Speaker Driver.igs

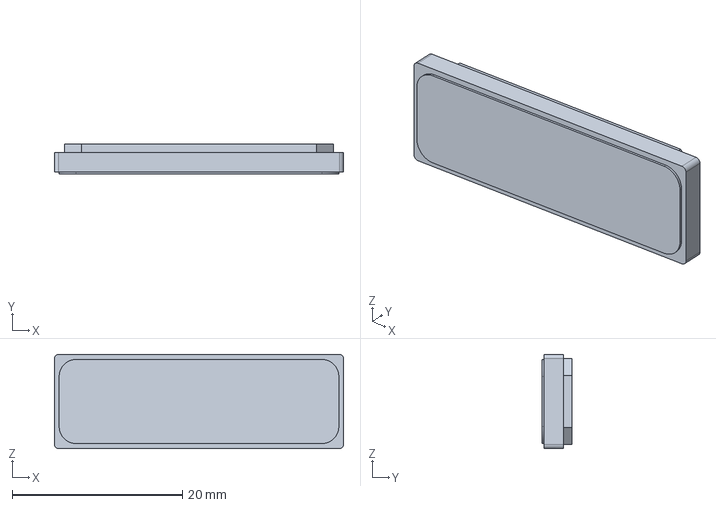
[picture p51: CAD file, 2025-08-28]
CAD/Speaker/Speaker Driver.igs
34.0 x 3.50 x 11.1 mm
