KCB101/Frankenbook/CAD/Speaker/Speaker Housing Upside.igs

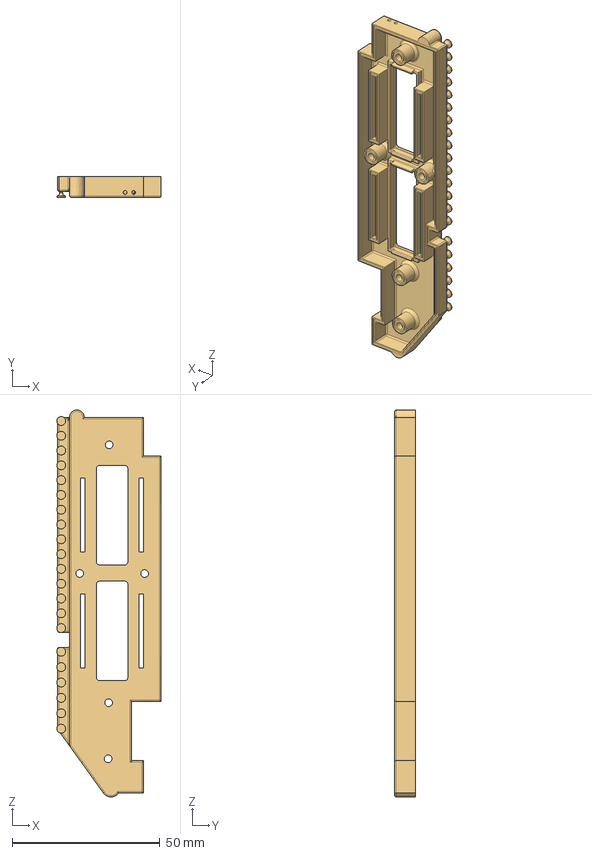
[picture p52: CAD file, 2025-08-28]
CAD/Speaker/Speaker Housing Upside.igs
35.3 x 7.00 x 130.8 mm
