KCB101/Frankenbook/(list of files, cad)

Other CAD files:
CAD/Housing Parts/dvddrive.ipt
CAD/Housing Parts/firewire.ipt
CAD/Speaker/Speaker Assembly.iam
CAD/Speaker/Speaker Driver.ipt
CAD/Speaker/Speaker Housing.ipt
CAD/Speaker/Speaker Housing/Downside.ipt
CAD/Speaker/Speaker Housing/Upside.ipt
