KCB101/Frankenbook/PCB Design/01 Internal Ports/rev. 04/Laptop2 - Laptop2 - Project.pdf

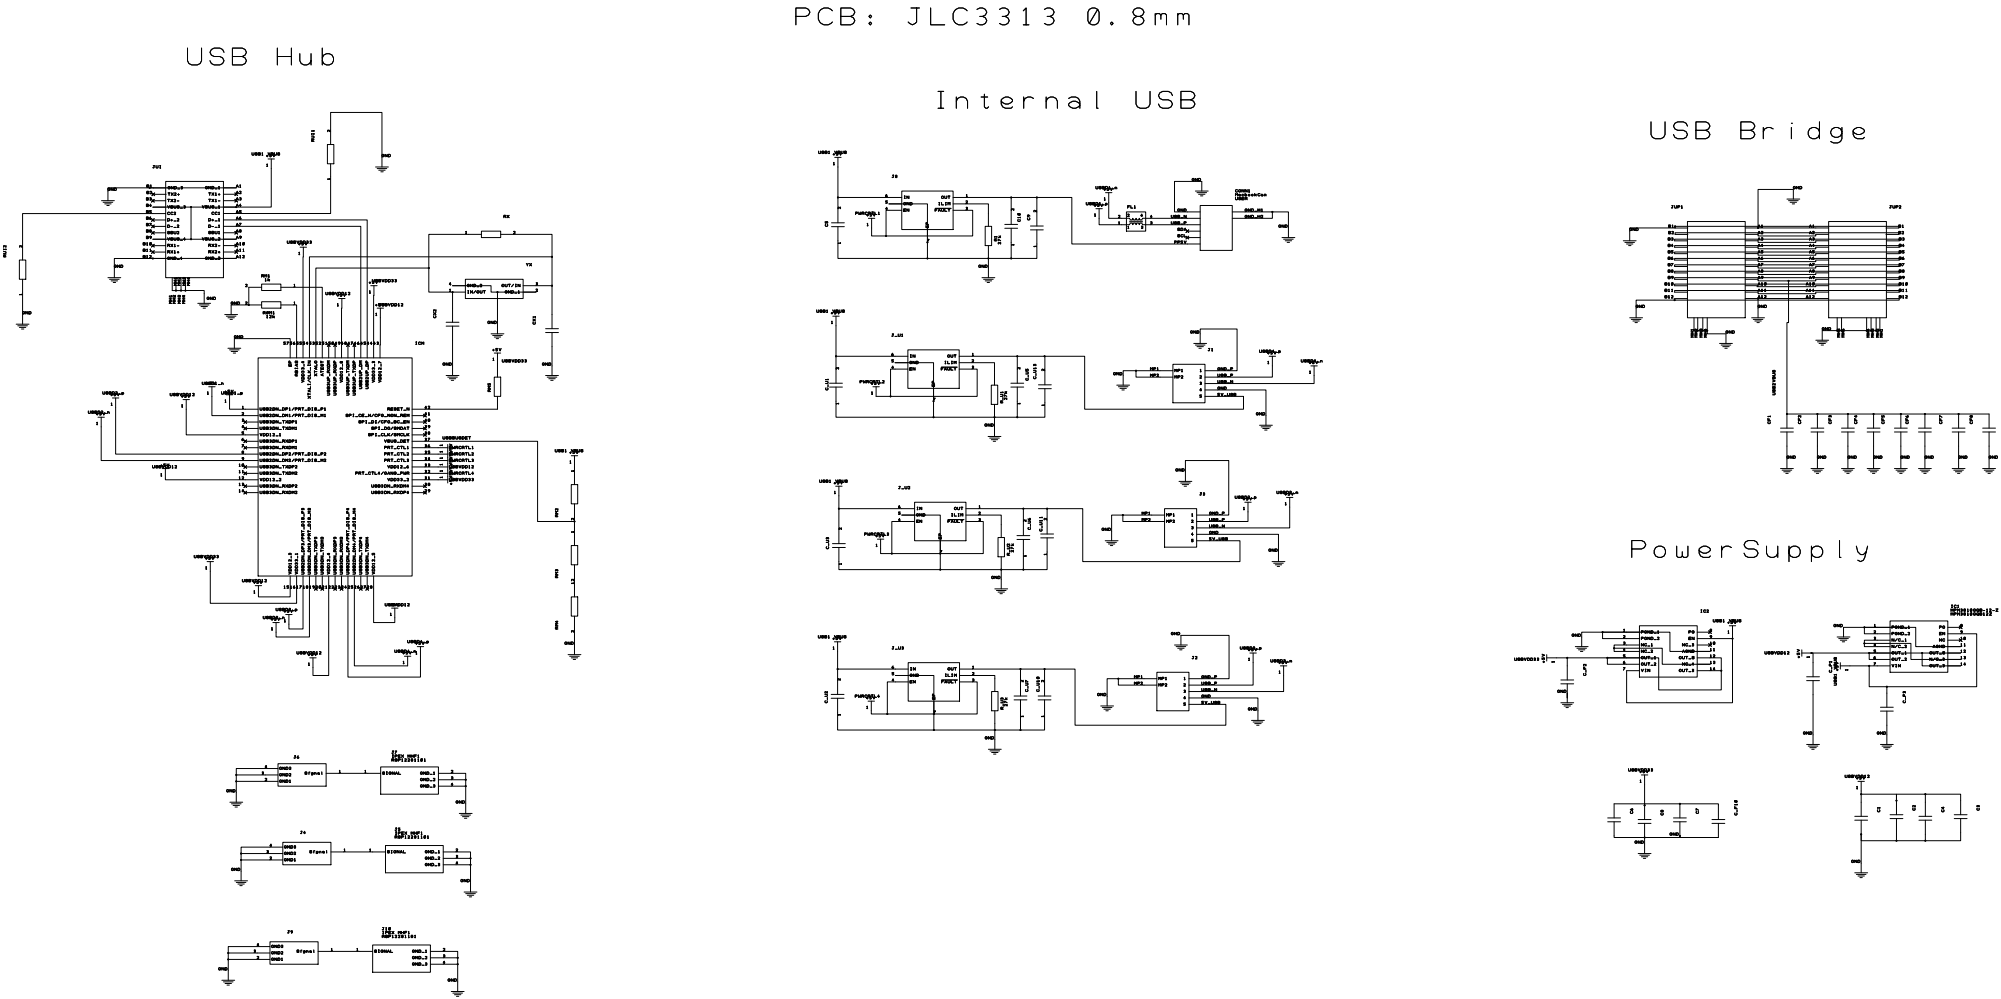
[picture p53: page 1]
