KCB101/Frankenbook/PCB Design/02 External Ports/rev. 05/Laptop - Laptop - Project.pdf

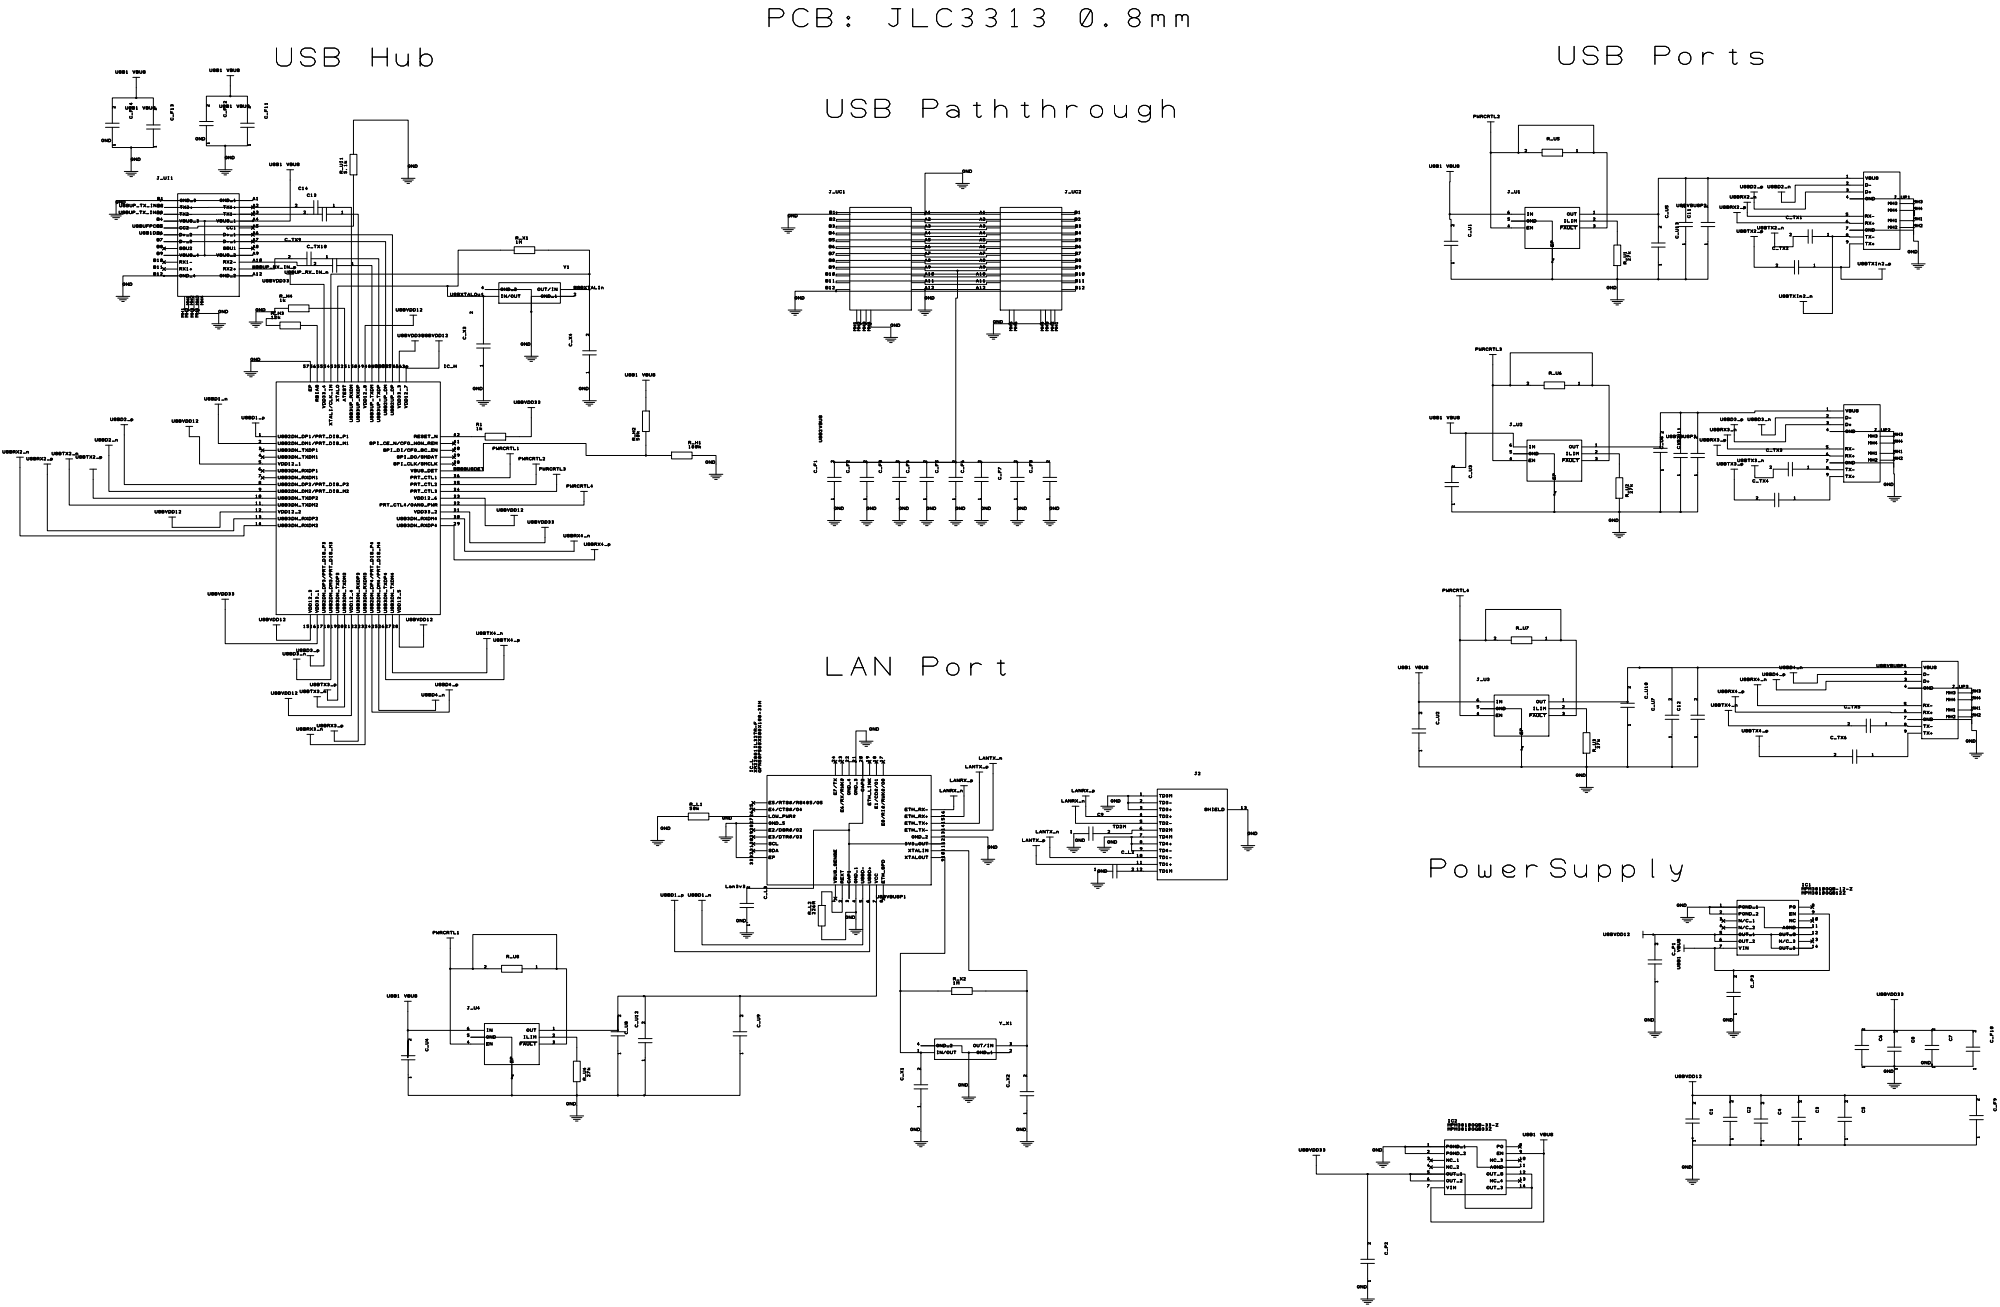
[picture p54: page 1]
