KCB101/Frankenbook/PCB Design/03 Keyboard Handler/Rev. 03/Laptop3 - Laptop3 - Project.pdf

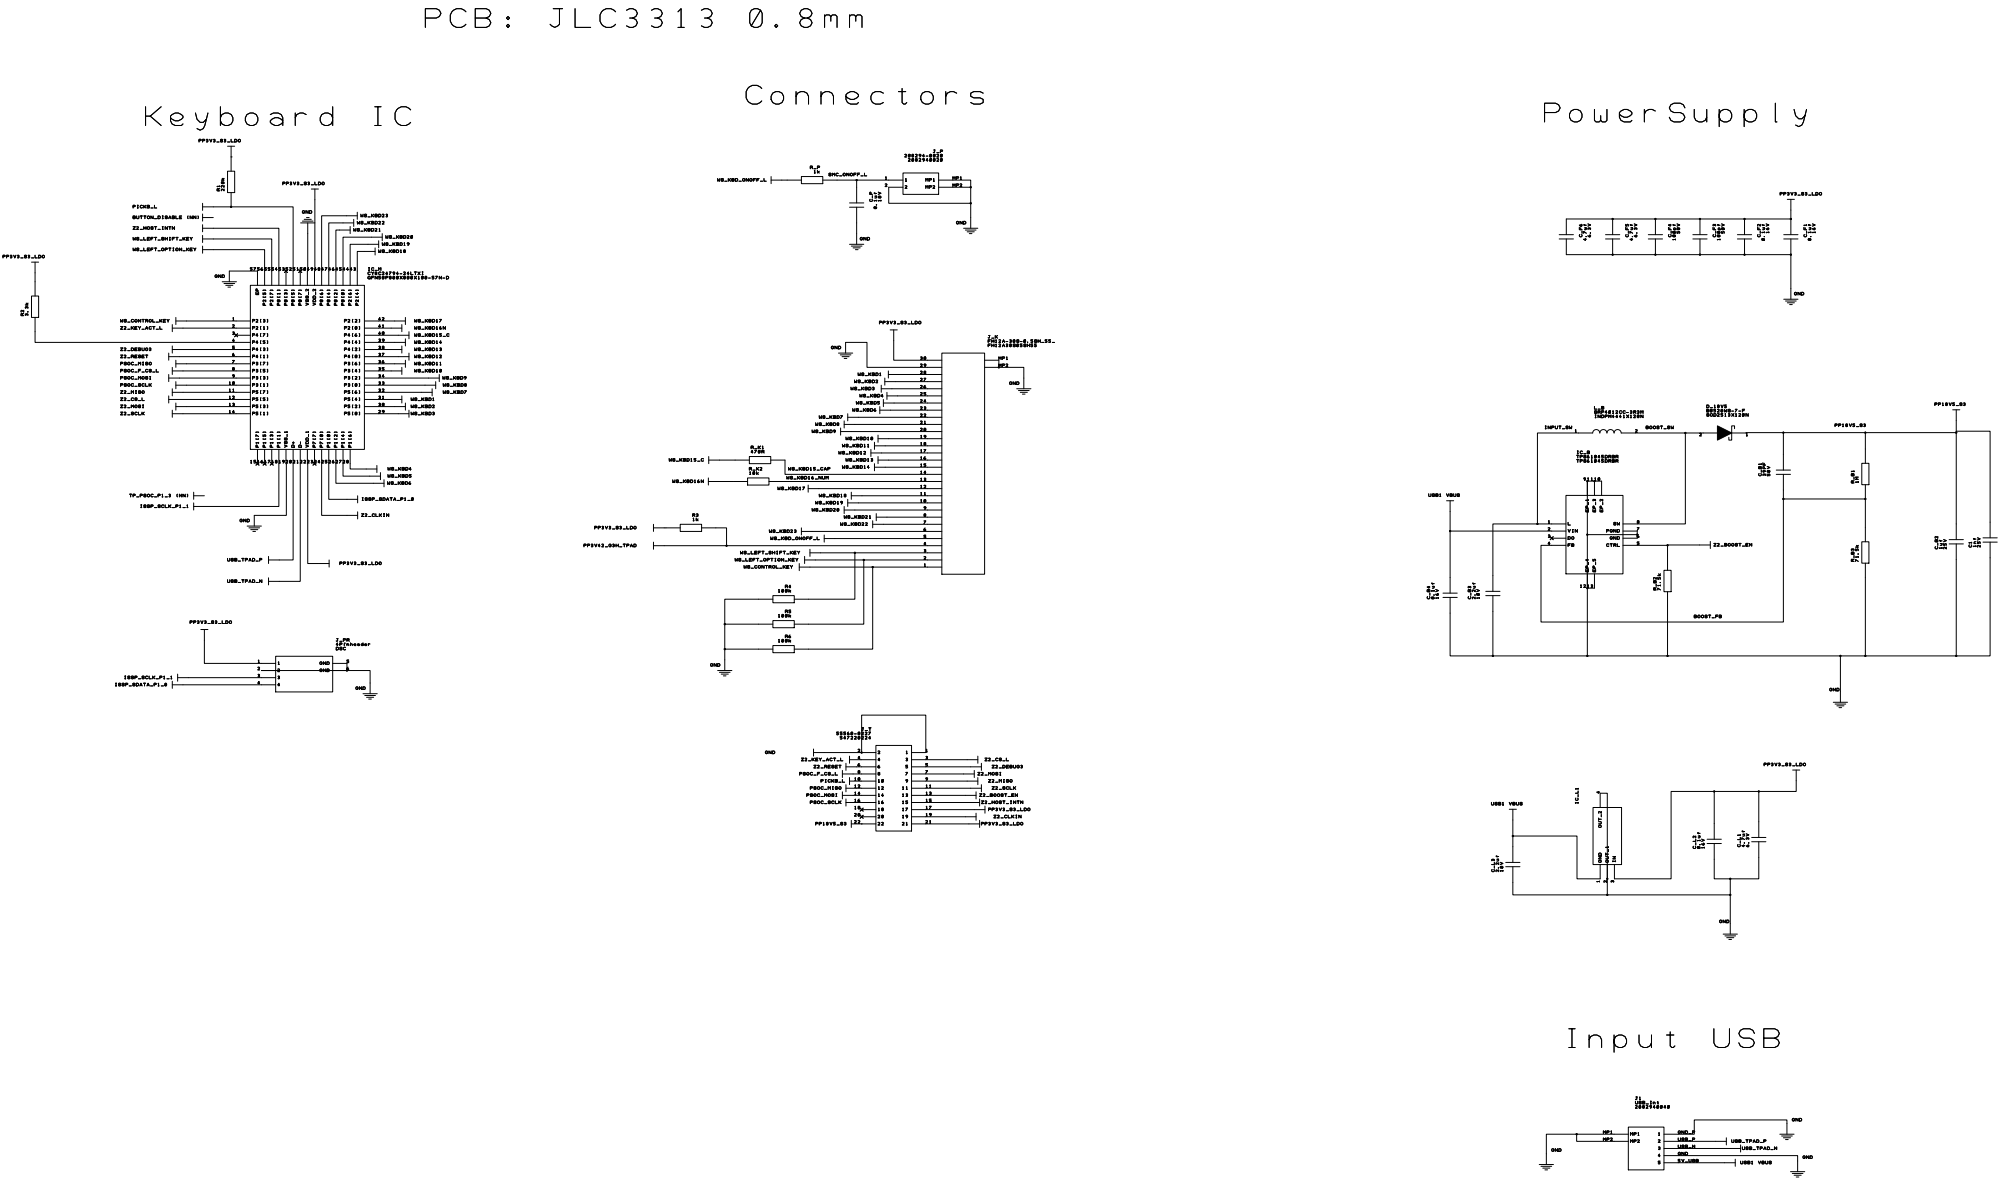
[picture p55: page 1]
