KCB101/Frankenbook/PCB Design/06 chargestate/rev. 00/StateBoard - StateBoard - Project.pdf

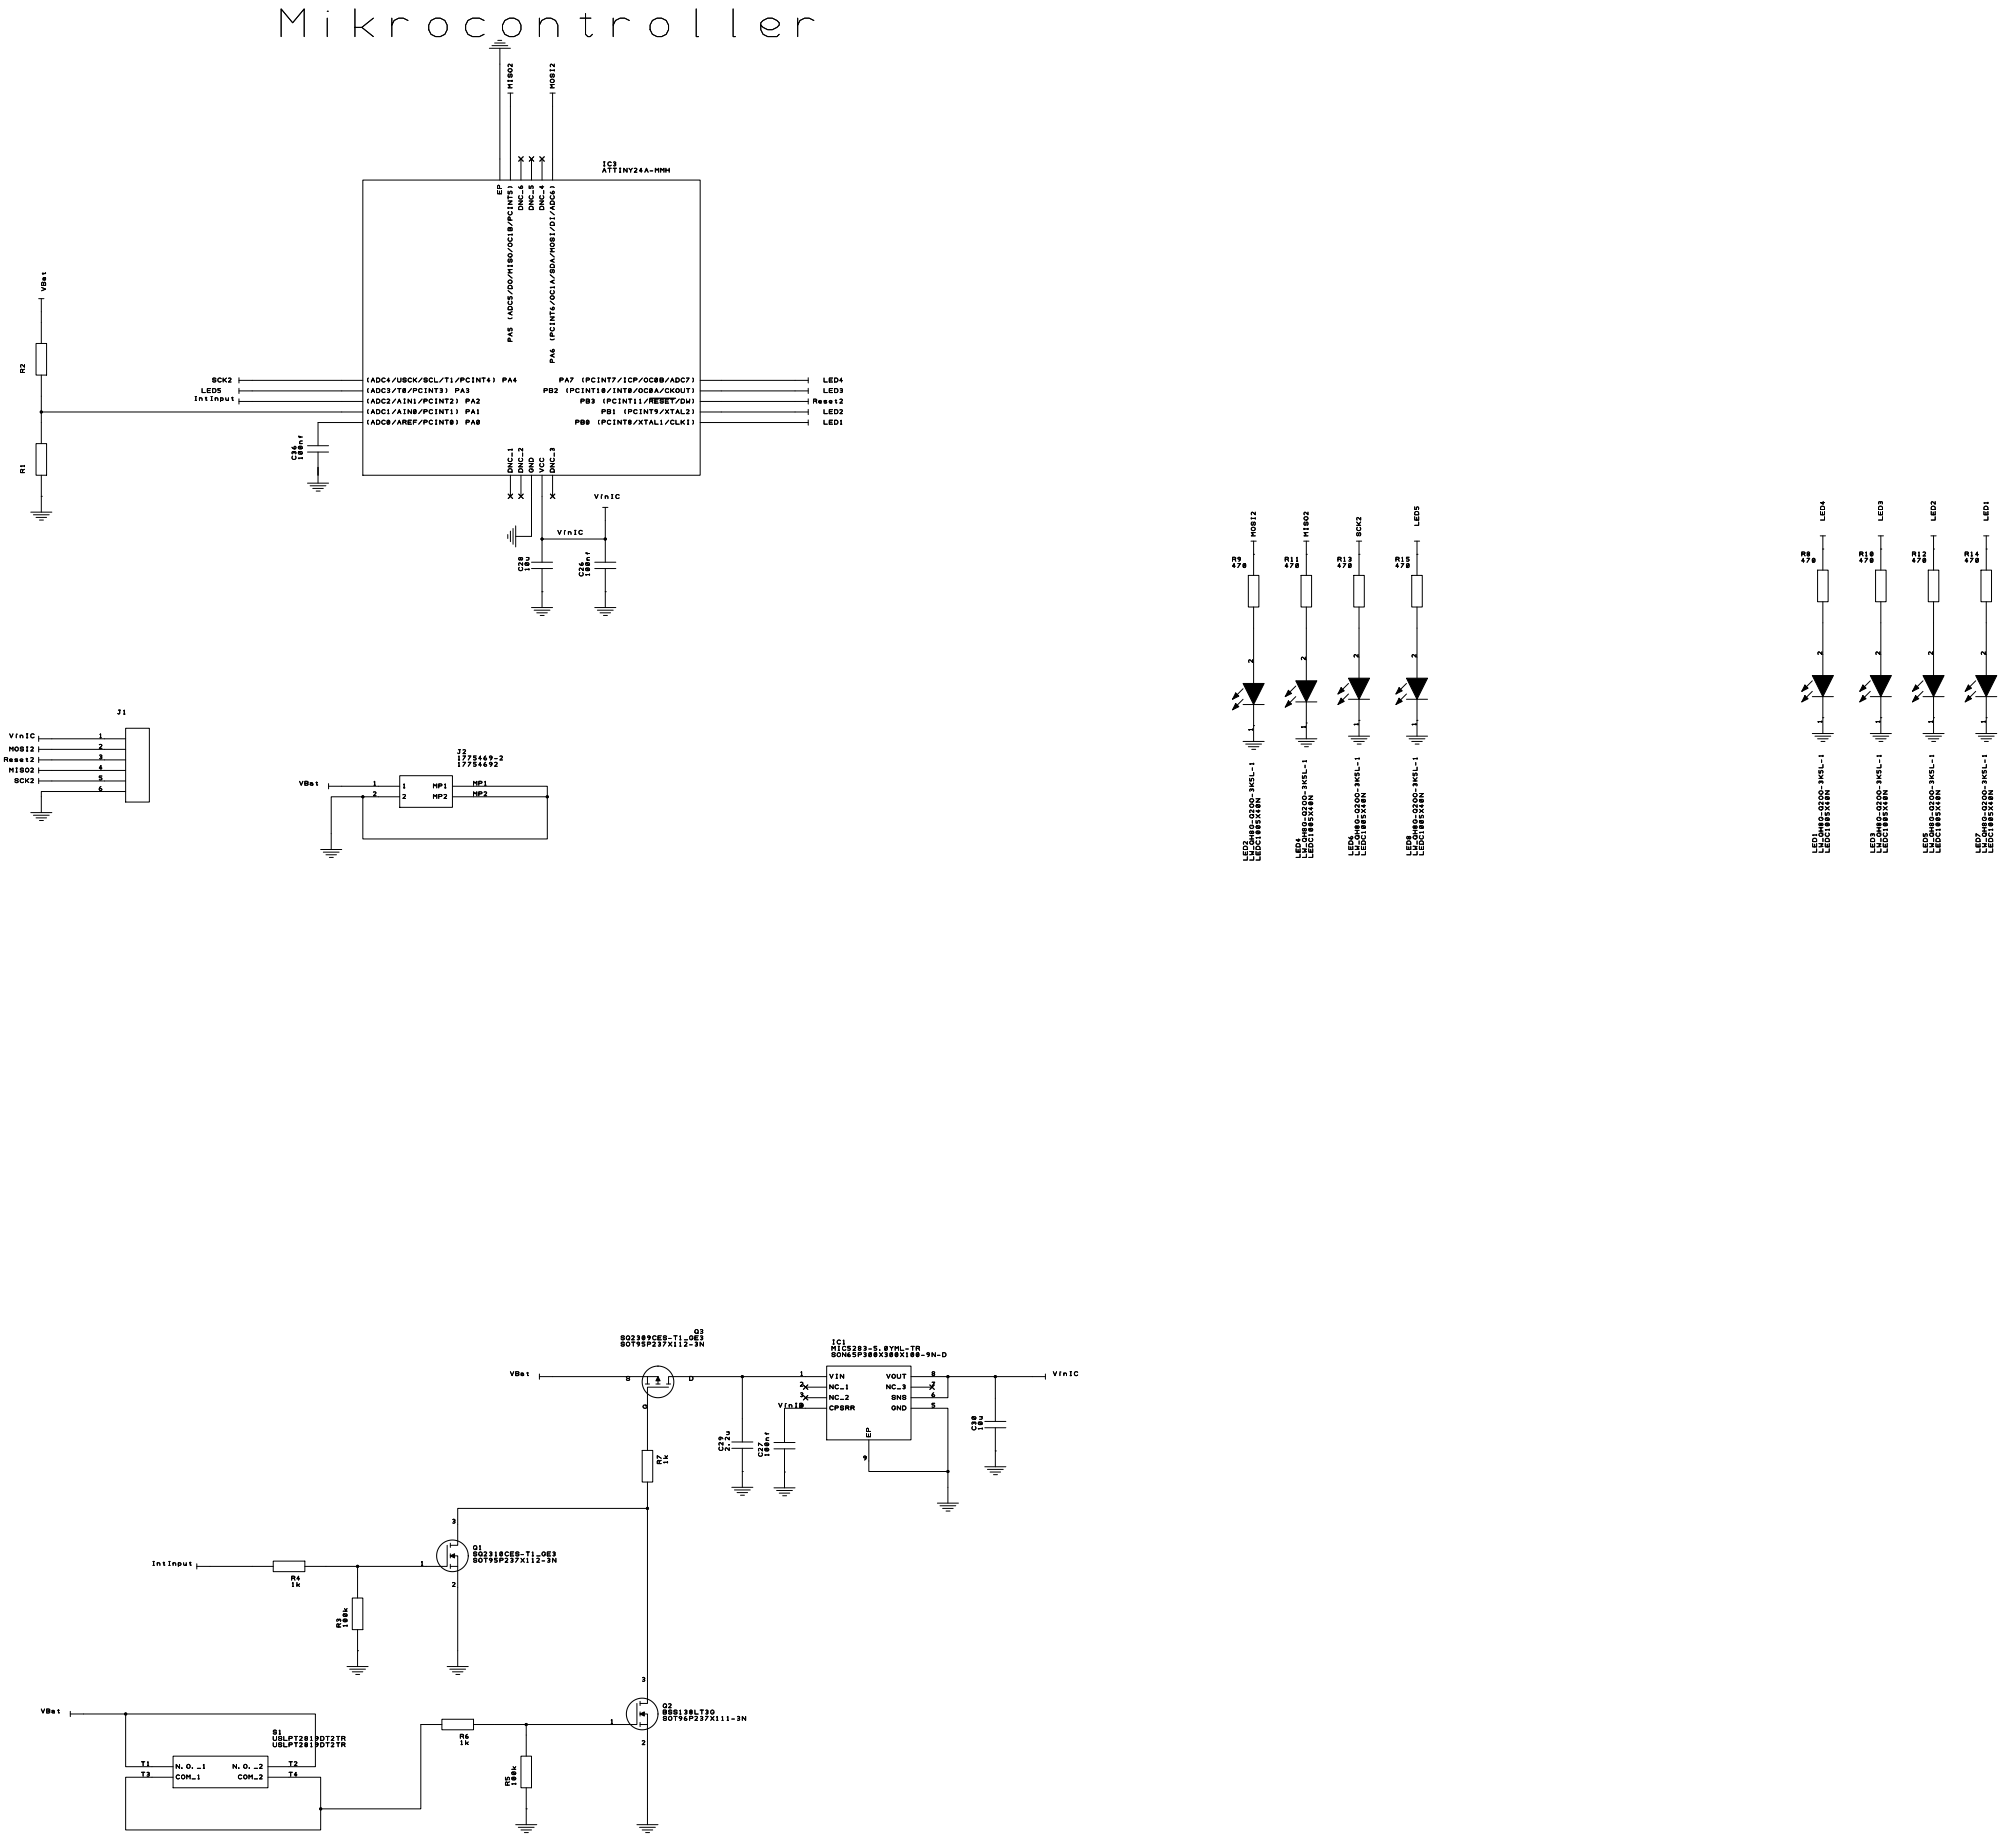
[picture p56: page 1]
