KCB101/Frankenbook/(list of files, drawings)

Other design files:
PCB Design/01 Internal Ports/rev. 04/Laptop2.pcb
PCB Design/01 Internal Ports/rev. 04/~Laptop2.pcb
PCB Design/02 External Ports/rev. 05/Laptop.pcb
PCB Design/02 External Ports/rev. 05/~Laptop.pcb
PCB Design/03 Keyboard Handler/Rev. 03/Laptop3.pcb
PCB Design/03 Keyboard Handler/Rev. 03/~Laptop3.pcb
PCB Design/04 Holders/Holder1.pcb
PCB Design/04 Holders/Holder2.pcb
PCB Design/04 Holders/Holder3.pcb
PCB Design/04 Holders/Holder4.pcb
PCB Design/04 Holders/~Holder2.pcb
PCB Design/04 Holders/~Holder4.pcb
PCB Design/05 Charger/Laderegler 4s 17.6/Rev.02/Chargeunit.pcb
PCB Design/06 chargestate/rev. 00/StateBoard.pcb
PCB Design/06 chargestate/rev. 00/~StateBoard.pcb
